bubbulle/CDR_ATOM_FACTORY_2019/Divers/Rapports/Base roulante CDR 2019.pdf

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

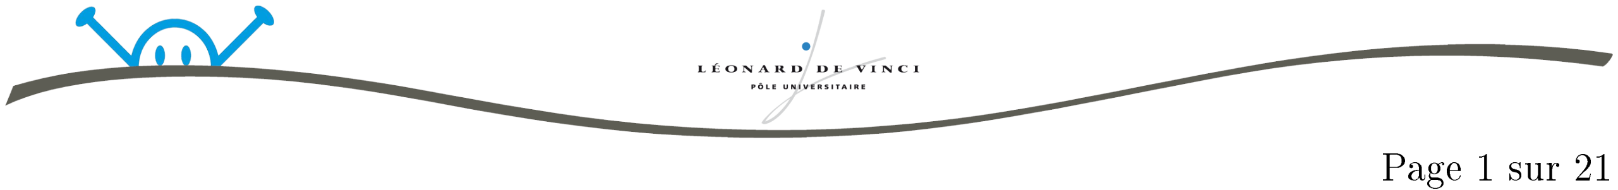
[picture p2: figure]

BASE ROULANTE CDR 2019

## Table des matières

1 | Dénir les moteurs | 4
2 | Conception de la base roulante en CAD | 7
3 | Fabrication de la base roulante | 10
4 | Système d'alimentation | 11
5 | Carte de contrôle des moteurs | 12
6 | Etude des codeurs incrémentaux | 13
7 | PID | 14
8 | ROS | 16
9 | Calcul de trajectoire simple à 2 points | 17
10 Système d'évitement | 18
11 Asservissement et vision par ordinateur | 19

Page 2 sur 21

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

## Dénir les moteurs

### Introduction

An de dénir les moteurs pour la CDR, il est important de justier nos choix par le calcul. En eet, il faut considérer la vitesse de déplacement du robot, le travail à eectuer et la puissance de chaque moteur.
Chaque mesure est prise de façon empirique, on veut juste avoir une approximation des résultats pour cibler nos recherches.
On suppose que la table sera toujours plan, ainsi le robot ne doit pas monter de pente. Dans le cas contraire, une nouvelle étude sera nécessaire.
Pour les calculs, on donne la longueur de la table 3m, le diamètre de la roue 50mm et le poids du robot 5kg.

### Dénir vitesse, puissance, et couple

Vitesse :
On souhaite parcourir la table en 5s : Vmax = D/t = 3m/5s = 0.6m.s⁻¹

Si les roues font 50mm de diamètre, leur périmètre est de :

Proue = π.d = π.0.05 = 0.15707m = 157.07mm

La vitesse de rotation à l'entrée des roues :

Nmax =

Vmax
Proue

.60 = 229, 20 tr.min⁻¹

ωmax =

2.π.N

60 | = 24, 00 | rad.s⁻¹

Page 4 sur 21

Travail des forces et énergie cinétique :

∆Ec =

XWFext | (1)

Ec = 1/2.m.V (t)

2
(2)

⇒ 1/2.m.(V (t)

2 − V (0)²
) = F.D où D est la distance parcouru par le robot

⇔ F = 1/2.m.V ²
max.

1
D
= 0.3N | (3)

Couple

C = F.d/2 = 0.3 ∗ 0.025 = 0.0075Nm = 7.5mNm | (4)

Puissance
P = F.Vmax = C.ωmax = 0, 18W | (5)

On remarque que le couple et la puissance sont calculés pour l'ensemble du robot et non pour chaque moteur.
On divise donc C et P par 2

Cmoteur = 3, 75 mNm

Pmoteur = 0.09 W

(6)

Accélération

On sait que :

m.a =

P
Fext

⇒ a =

F
m

=

0.3
5

= 0.06m.s⁻²
(7)

Page 5 sur 21

### Moteur Faulhäber

En cherchant dans le catalogue Faulhäber, on trouve :

DC-Micromotors Series 2642...CXR (https://www.faulhaber.com/en/products/series/2642cxr/) mettre datasheet dans dossier

Alimenté en Un = 12V , ce moteur tourne a une vitesse de N = 5800tr.min⁻¹ hors charge et un

couple max de Cmax = 25mNm.
En charge, on aura environ N = 5000tr.min⁻¹
et on remarque que le moteur, sans système d'engrenages, ne cédera pas face au couple nécessaire pour déplacer le robot.

Pour choisir le système d'engrenages, on calcul le rapport de réduction.

R =

Nmoteur.ηgearbox

Nmax

=

5000.0.83
230 = 18.04

D'après le catalogue, il existe :

Planetary Gearheads Series 26/1R (https://www.faulhaber.com/en/products/series/261r/)

mettre datasheet dans dossier

A cause d'un problème de dimension sur les poulies, on choisit le réducteur de rapport 14 :1. Ainsi, le rapport de réduction des poulies doit être de 1,86.

Page 6 sur 21

## Conception de la base roulante en CAD

### Introduction

Pour concevoir une base roulante stable, précise, et réutilisable, nous avons besoin que celle-ci soit facile à étudier, rapide à monter et surtout qu'elle réponde aux critères de précision. En eet, tout l'enjeu du robot est de pouvoir se déplacer avec le moins de contrainte possible. Les contraintes sont :

Entre-axe centré

Roue adhérente et bien xée

Pour des raisons de précision et tactique, des roues folles seront utilisées pour l'odométrie du robot. Ainsi, il y aura 2 types de roues, 2 roues large pour le mouvement et 2 roues folles pour les encodeurs. Toutes les roues ont le même diamètre pour éviter d'autres erreurs de calculs. Les roues folles sont placées le plus à l'extrémité pour augmenter la précision.

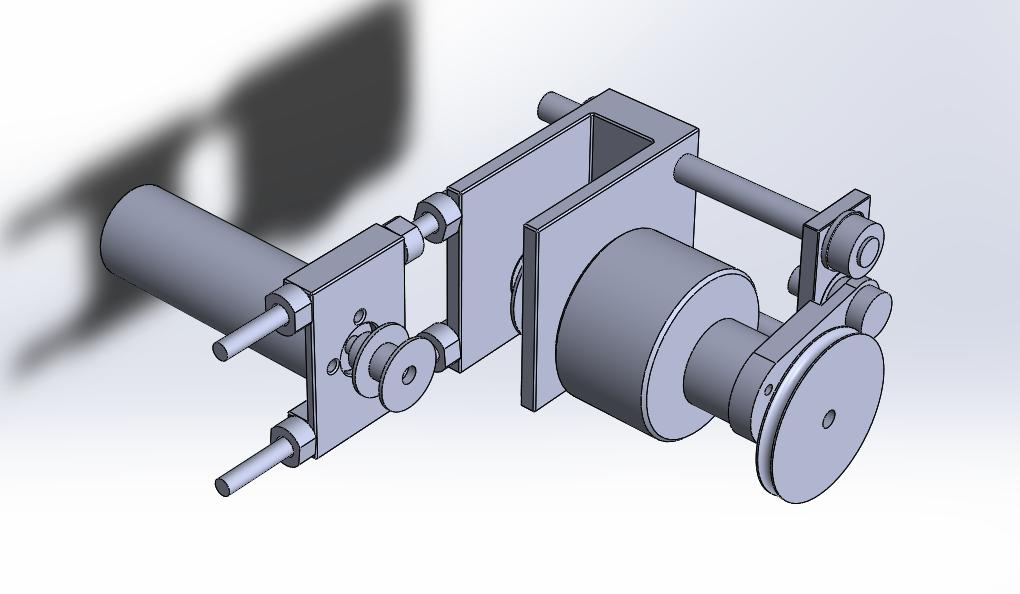
[picture p3: figure]

Page 7 sur 21

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

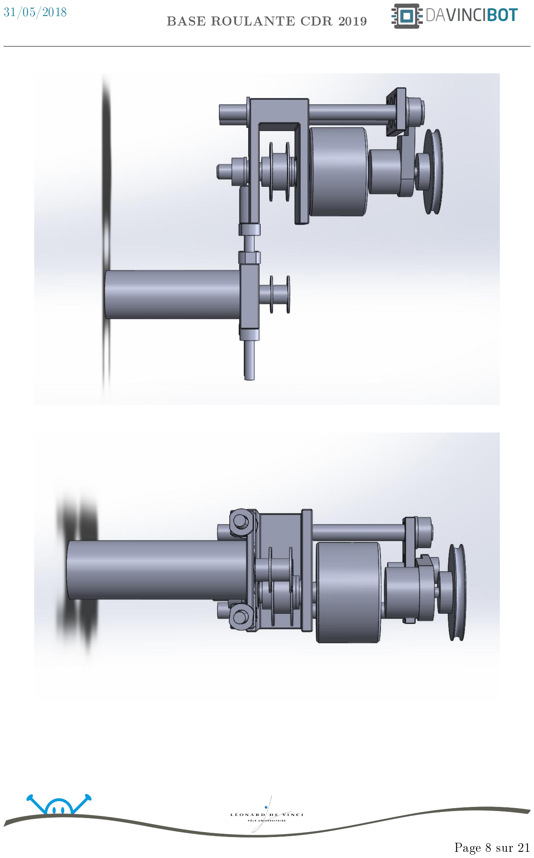
[picture p4: page 8]

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

## Etude des codeurs incrémentaux

Les codeurs incrémentaux sont utilisé pour mesurer les rotations eectuées. Très utilisés dans l'industrie, les codeurs nous servent pour l'odométrie du robot.

Il existe diérent type de codeurs, les magnétiques et les optiques. Chaque codeurs possède une résolution, celle-ci est mesurer en impulsions par tour.

Voici la réprésentation d'un disque pour les codeurs :

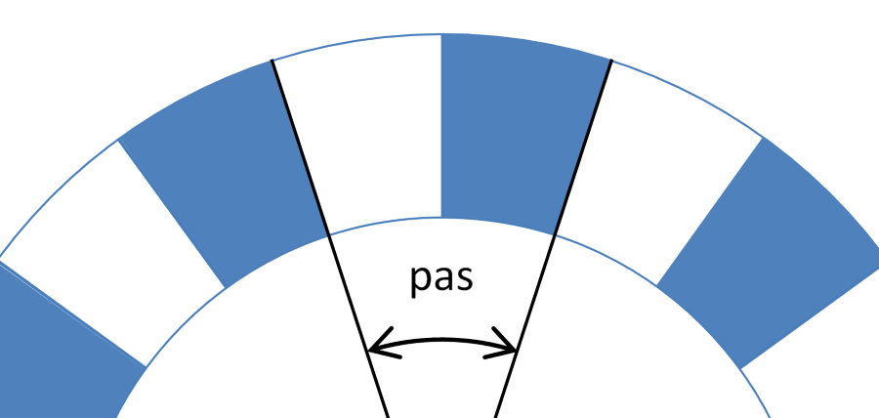
[picture p5: figure]

Le principe de fonctionnement est très bien expliqué sur ce site (http://arduino.blaisepascal.fr/index.php/2017/02/05/les-codeurs-incrementaux/)

Vous pourrez trouver les codes dans le chier "Codeurs incrémentaux". Les codes sont disponible en C pour arduino, C++ pour raspberry avec WiringPi, et enn en python pour raspberry avec RPi.GPIO

fait sur arduino, en cours sur rasp. sera nit pour vendredi 14

Page 13 sur 21

## PID

### Qu'est-ce que c'est ?

"Un correcteur est un algorithme de calcul qui délivre un signal de commande à partir de la diérence entre la consigne et la mesure."

Ce système est décomposé en 3 parties :

P (proportionnel)

PI (proportionnel et intégré)

PID (proportionnel, intégré, et dérivé)

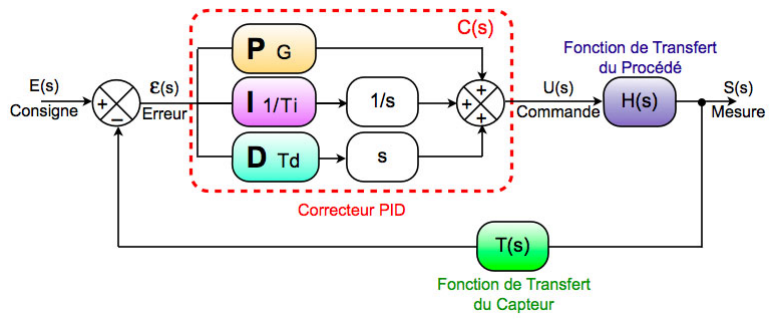
[picture p6: figure]

Pour avoir un régulateur précis, on utilise le correcteur PID. La correction résulte de la somme des trois P + I + D. On a la fonction de transfère, sous Laplace, suivante :

C(p) = G +

1
Ti

.p

+ Td.p | (8)

Page 14 sur 21

Le correcteur doit être bien dimensionné pour éviter les phénomènes d'oscillations et mi-nimiser le temps de réponse du système. On remarque ces deux phénomènes sur le graphique ci-dessous.

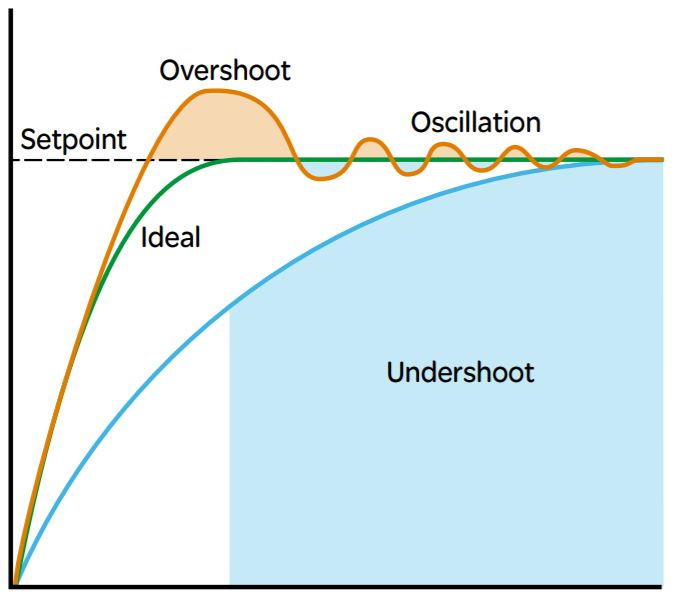
[picture p7: figure]

Les codes du PID en C++ et python ne sont pas disponible maintenant car ils n'ont pas été testés.

Page 15 sur 21

## ROS

Dans la partie ROS, nous allons implémenter des fonctionnalités plus poussée que celles de simples publisher et subscriber.
Il existe les services, et les actions. Les services sont utilisés comme un protocole dit : Request / Reply.

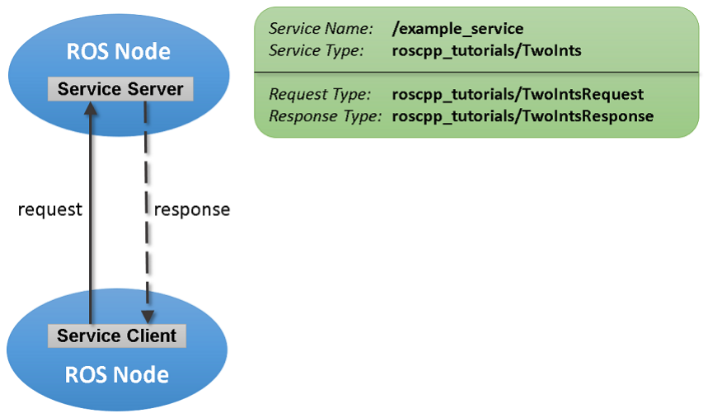
[picture p8: figure]

Les actions ont le même principe, seulement il existe plusieurs étapes intermédiaires entre la requête et la réponse. Voici le schéma d'organisation d'une action.

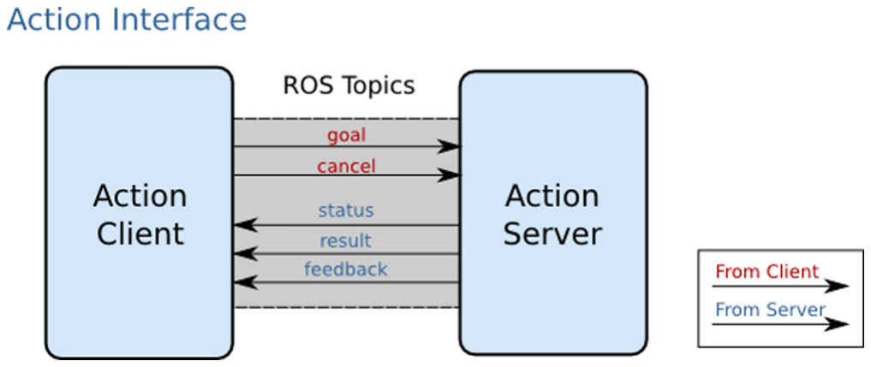
[picture p9: figure]

Pas de code utilisable

Page 16 sur 21

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
