bubbulle/CDR_ATOM_FACTORY_2019/CAO/Base Roulante/SW_BR_3.0/IMP_ECRAN/cote_3.0.png

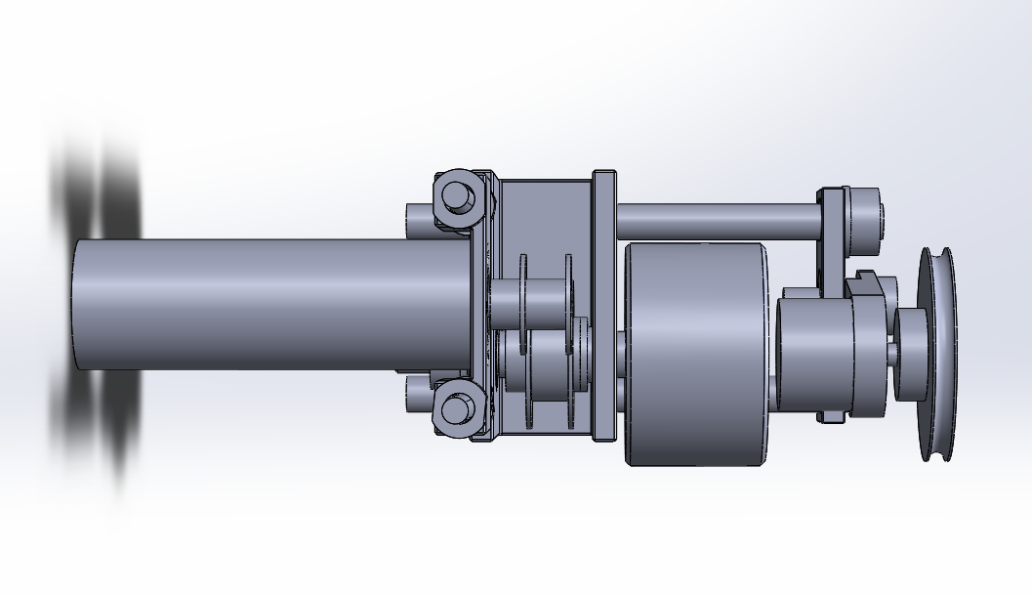
CAO/Base Roulante/SW_BR_3.0/IMP_ECRAN/cote_3.0.png
