bubbulle/CDR_ATOM_FACTORY_2019/CAO/Base Roulante/SW_BR_1.0/Assemblage1.SLDASM

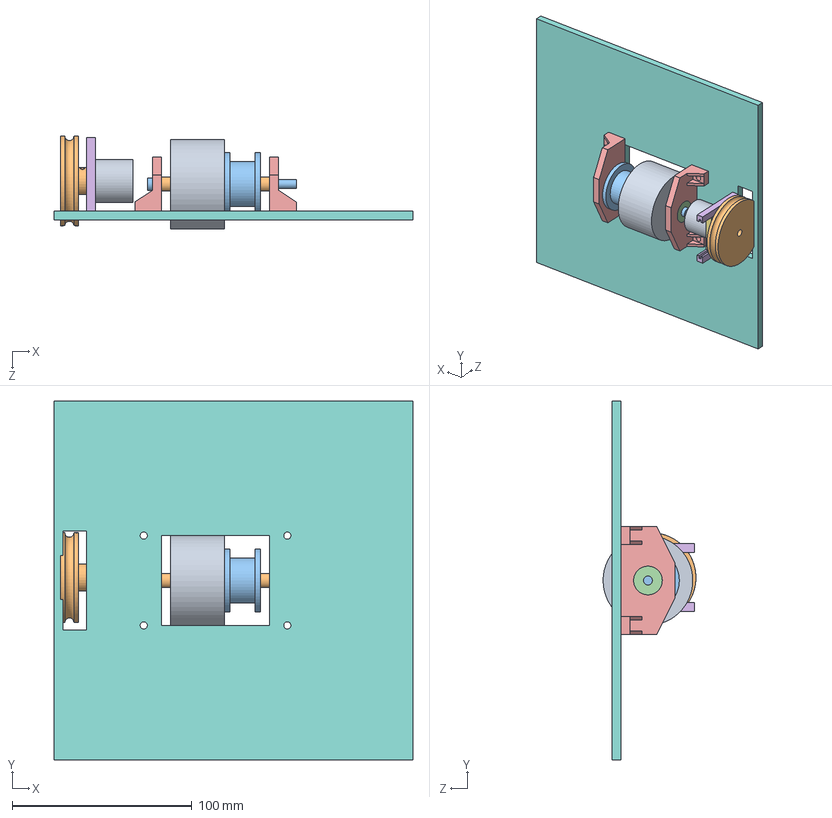
[picture p12: CAD file, 2018-09-26]
CAO/Base Roulante/SW_BR_1.0/Assemblage1.SLDASM
200.0 x 200.0 x 51.7 mm
roues
cale moteur x 2
poulie
roulement 5x16 x 2
support roues vé x 2
support du support encodeur
support encodeur
base
encodeur
rouefolle
axe roues
goupille
