bubbulle/CDR_ATOM_FACTORY_2019/CAO/Base Roulante/SW_BR_2.0/Assemblage1.SLDASM

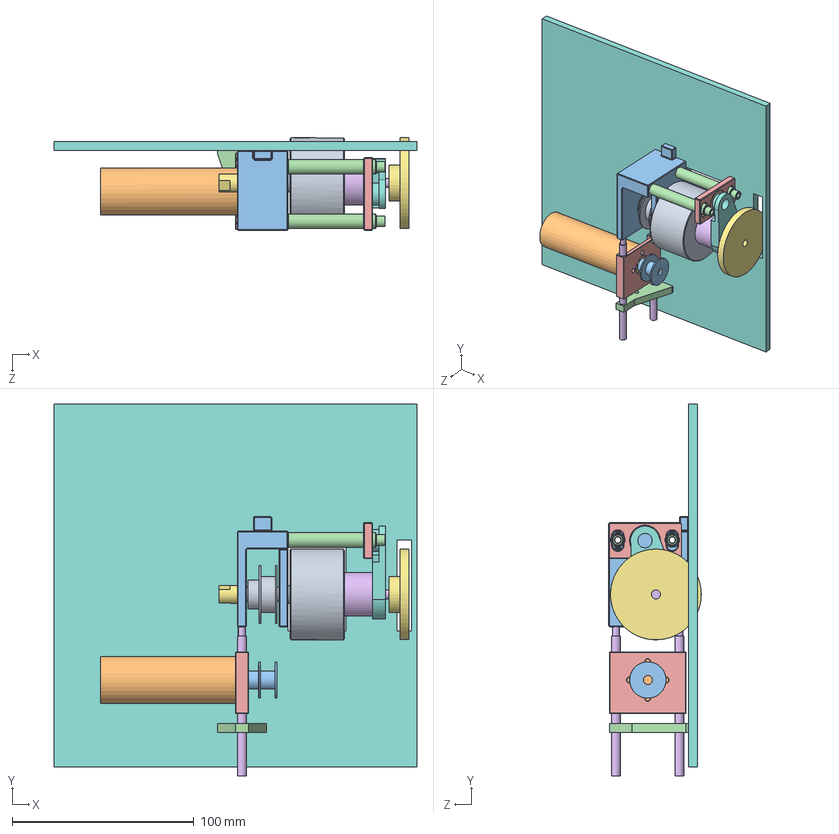
[picture p13: CAD file, 2018-09-26]
CAO/Base Roulante/SW_BR_2.0/Assemblage1.SLDASM
200.0 x 204.9 x 51.0 mm
roues
roulement 8int 16ext x 3
support roues
tige support encodeur x 2
support encodeurs
codeurs
roue folle
base
poulie
moteur faulhaber
poulie 20 dents
fixation tige support moteur
Pièce1
tige x 2
fixation encodeur V3
