bubbulle/CDR_ATOM_FACTORY_2019/CAO/Base Roulante/SW_BR_3.0/3.0/Base V3.SLDASM

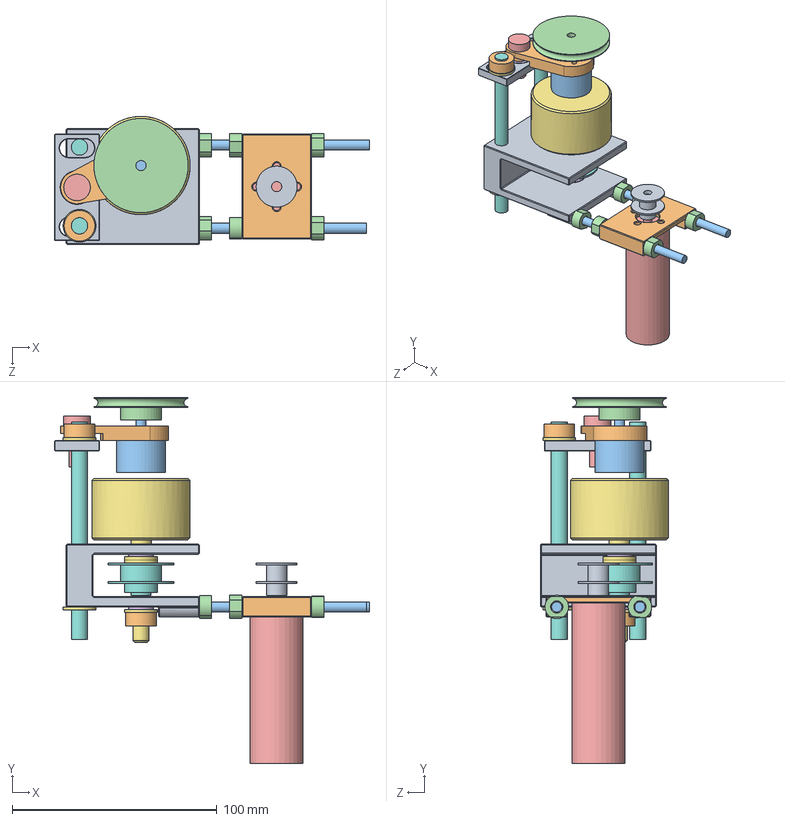
[picture p14: CAD file, 2018-09-26]
CAO/Base Roulante/SW_BR_3.0/3.0/Base V3.SLDASM
153.7 x 178.6 x 62.6 mm
Support fixe V3
support moteur V3
tige filetée M6 x 2
ecrou M6 x 6
moteur faulhaber
roulement 8int 16ext x 3
roues
tige filté M7 x 2
support encodeurs
fixation encodeur V3
codeurs
roue folle
vis M8 20L
rondelle M6 percée en M8 x 2
rondelle M8 x 5
poulie
poulie 20 dents
ecrou M8 x 2
