bubbulle/CDR_ATOM_FACTORY_2019/CAO/Base Roulante/SW_BR_1.0/support du support encodeur.SLDPRT

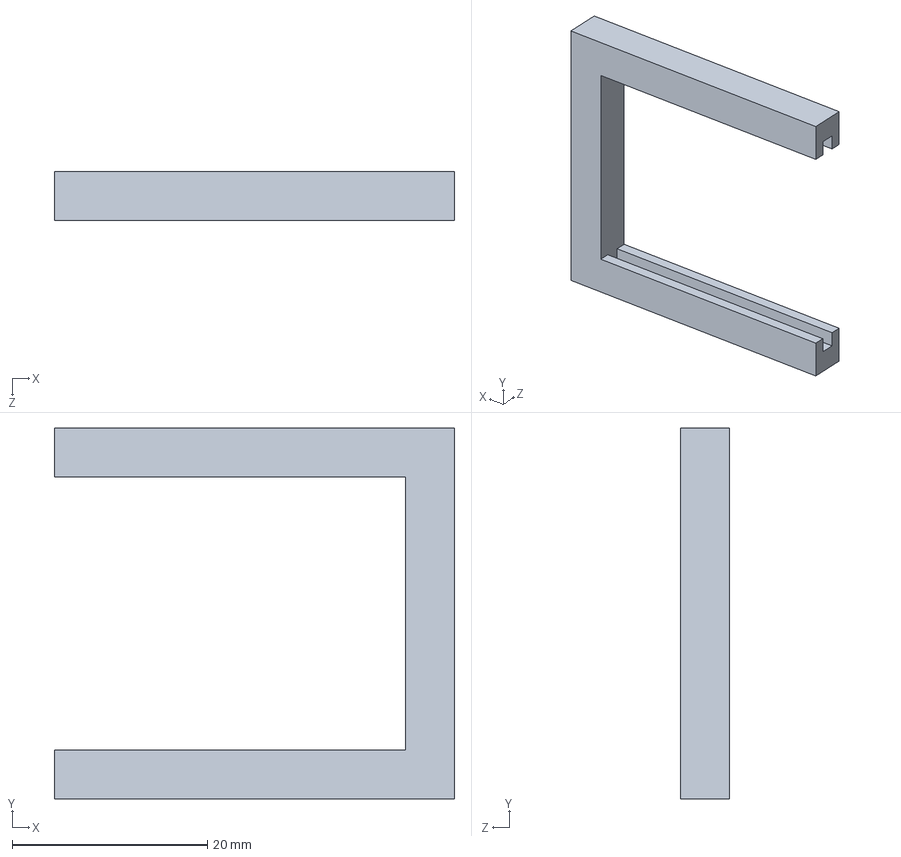
[picture p15: CAD file, 2018-09-26]
CAO/Base Roulante/SW_BR_1.0/support du support encodeur.SLDPRT
41.0 x 38.0 x 5.00 mm
