bubbulle/CDR_ATOM_FACTORY_2019/CAO/Base Roulante/SW_BR_3.0/3.0/roulement 8int 16ext.SLDPRT

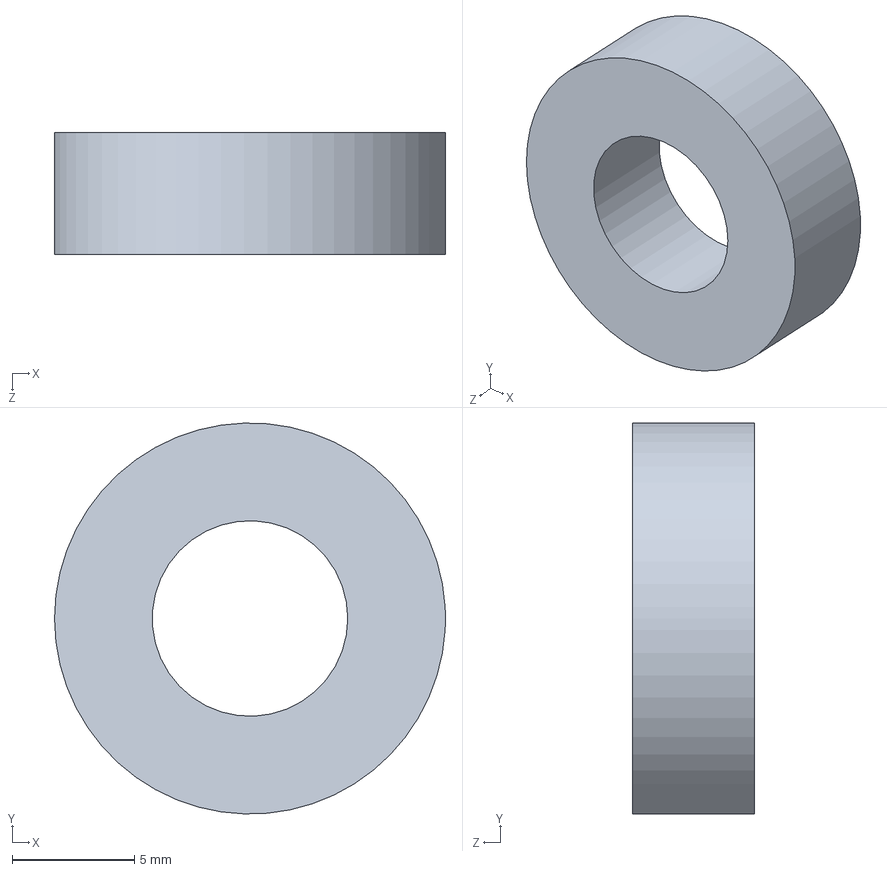
[picture p17: CAD file, 2018-09-26]
CAO/Base Roulante/SW_BR_3.0/3.0/roulement 8int 16ext.SLDPRT
16.0 x 16.0 x 5.00 mm
