bubbulle/CDR_ATOM_FACTORY_2019/CAO/Base Roulante/SW_BR_1.0/vis pour poulie.SLDPRT

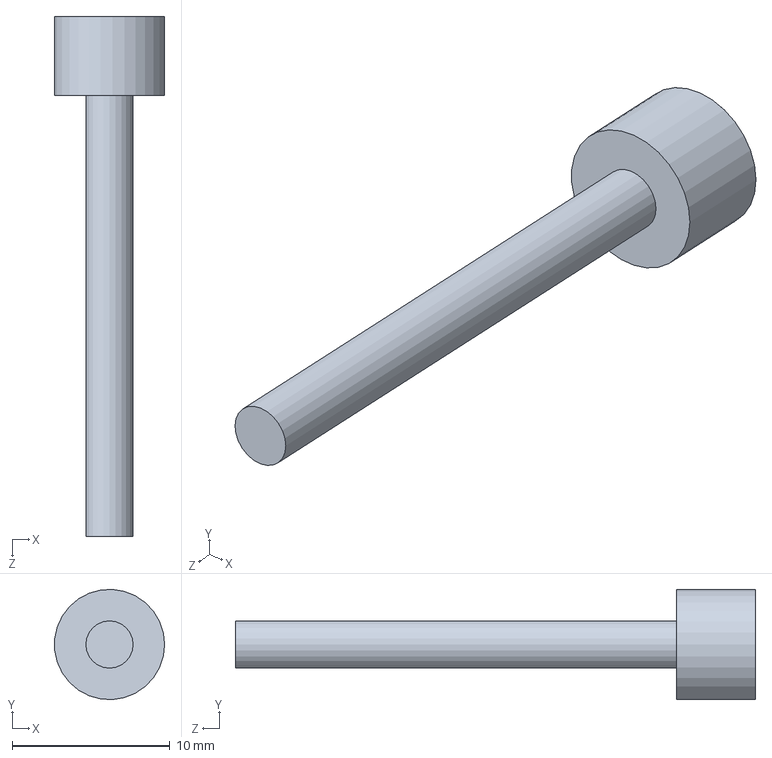
[picture p18: CAD file, 2018-09-26]
CAO/Base Roulante/SW_BR_1.0/vis pour poulie.SLDPRT
7.00 x 6.99 x 33.0 mm
