bubbulle/CDR_ATOM_FACTORY_2019/CAO/Base Roulante/SW_BR_2.0/base.SLDPRT

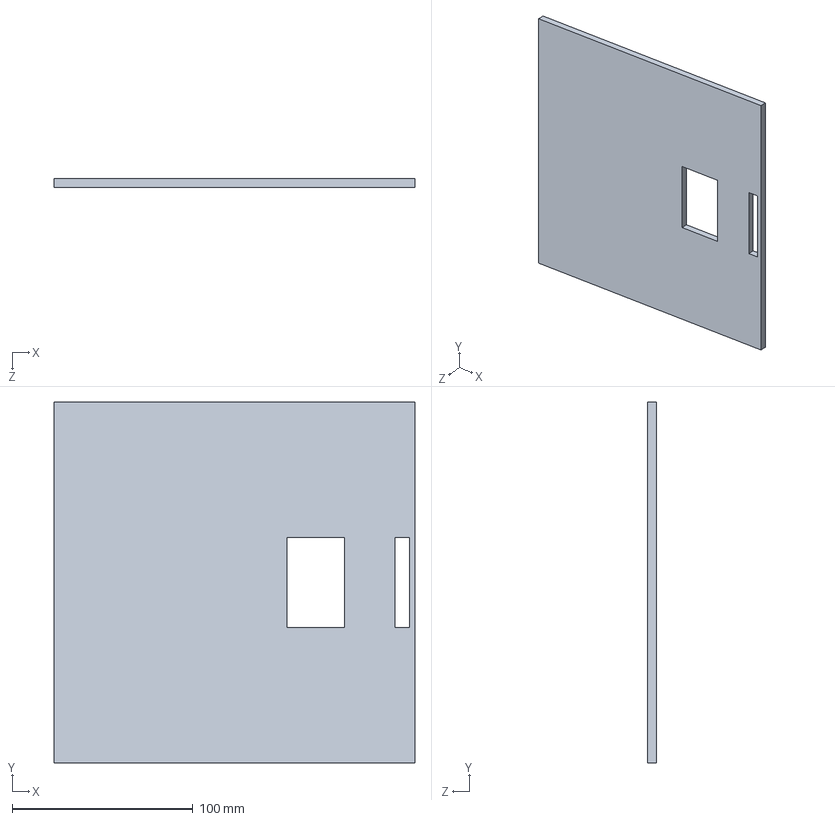
[picture p19: CAD file, 2018-09-26]
CAO/Base Roulante/SW_BR_2.0/base.SLDPRT
200.0 x 200.0 x 5.00 mm
