bubbulle/CDR_ATOM_FACTORY_2019/CAO/Base Roulante/SW_BR_3.0/3.0/rondelle M8.SLDPRT

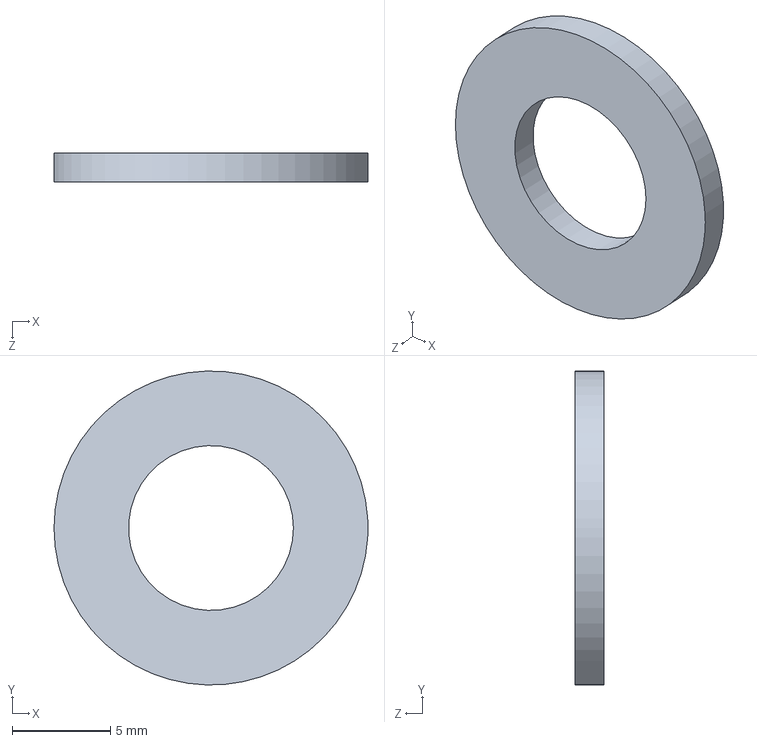
[picture p20: CAD file, 2018-09-26]
CAO/Base Roulante/SW_BR_3.0/3.0/rondelle M8.SLDPRT
16.0 x 16.0 x 1.50 mm
