bubbulle/CDR_ATOM_FACTORY_2019/CAO/Base Roulante/SW_BR_1.0/support roues.SLDPRT

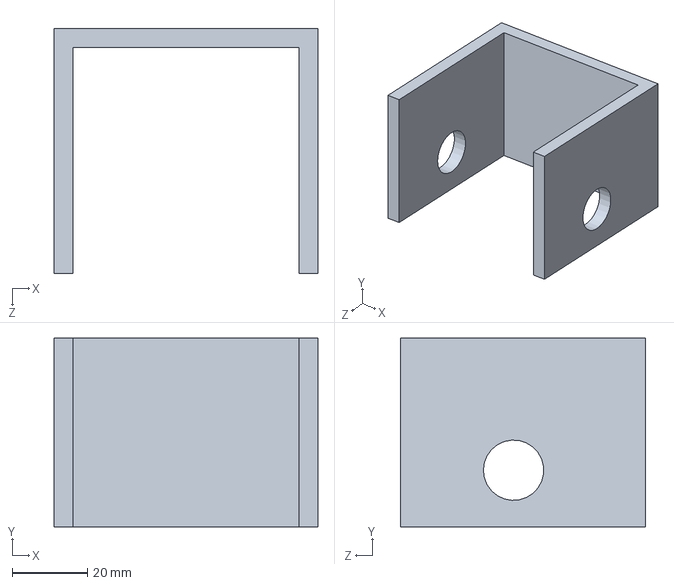
[picture p21: CAD file, 2018-09-26]
CAO/Base Roulante/SW_BR_1.0/support roues.SLDPRT
70.0 x 50.0 x 65.0 mm
