bubbulle/CDR_ATOM_FACTORY_2019/CAO/Base Roulante/SW_BR_2.0/ecrou axe central.SLDPRT

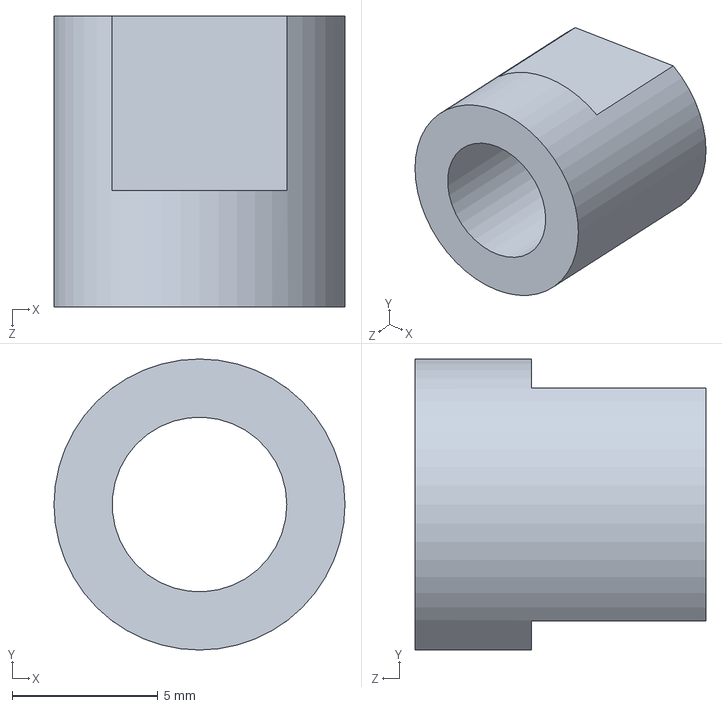
[picture p22: CAD file, 2018-09-26]
CAO/Base Roulante/SW_BR_2.0/ecrou axe central.SLDPRT
10.0 x 10.0 x 10.0 mm
