bubbulle/CDR_ATOM_FACTORY_2019/CAO/Base Roulante/SW_BR_3.0/3.0/tige filetée M6.SLDPRT

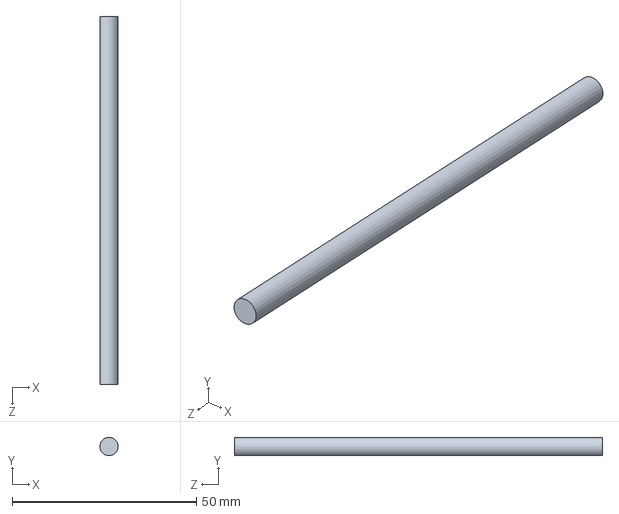
[picture p23: CAD file, 2018-09-26]
CAO/Base Roulante/SW_BR_3.0/3.0/tige filetée M6.SLDPRT
5.00 x 5.00 x 100.0 mm
