bubbulle/CDR_ATOM_FACTORY_2019/CAO/Base Roulante/SW_BR_1.0/support encodeur.SLDPRT

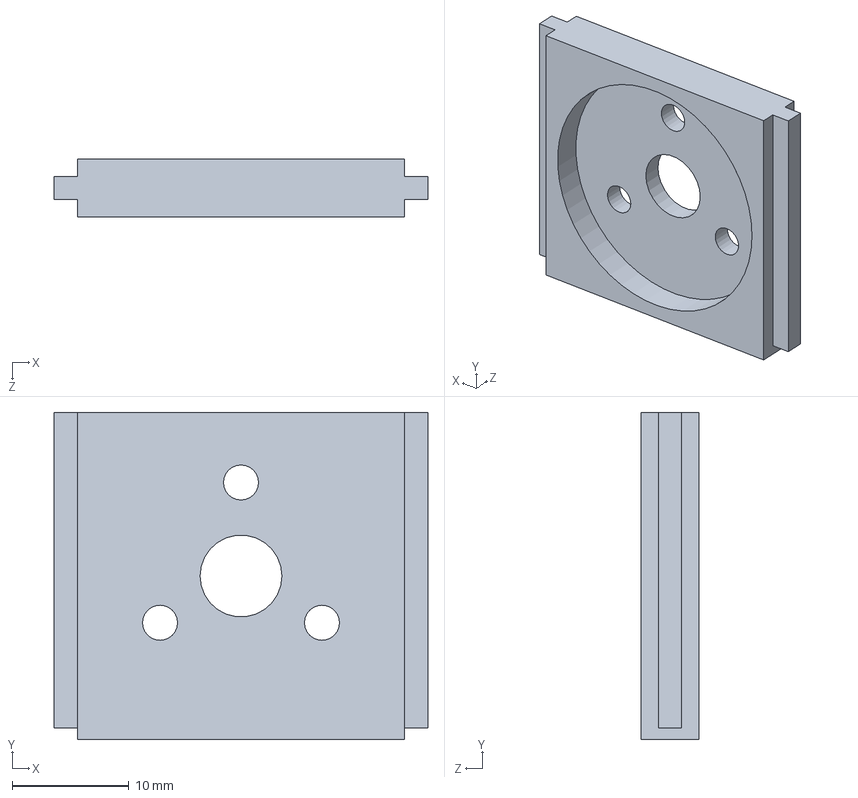
[picture p24: CAD file, 2018-09-26]
CAO/Base Roulante/SW_BR_1.0/support encodeur.SLDPRT
32.0 x 28.0 x 5.00 mm
