bubbulle/CDR_ATOM_FACTORY_2019/CAO/Base Roulante/SW_BR_2.0/poulie.SLDPRT

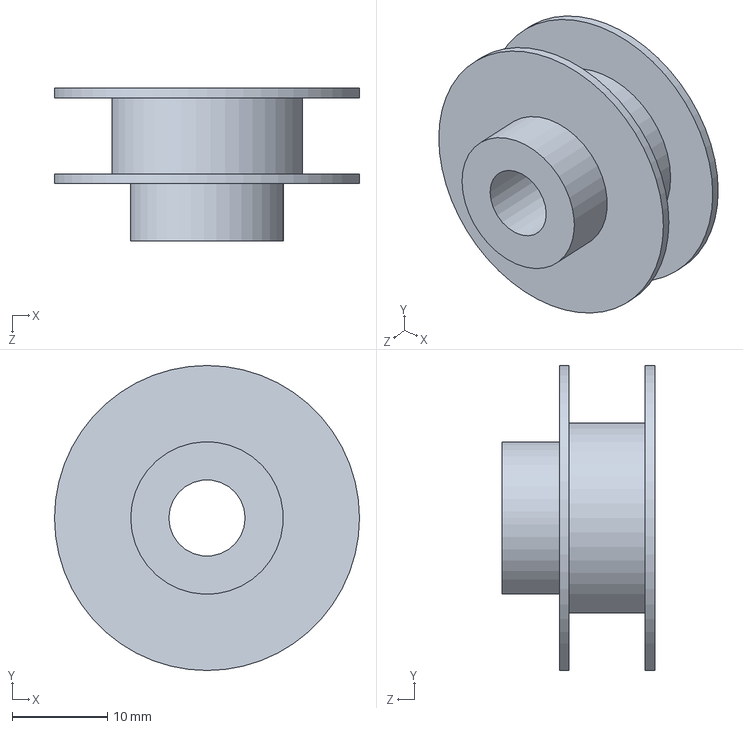
[picture p25: CAD file, 2018-09-26]
CAO/Base Roulante/SW_BR_2.0/poulie.SLDPRT
32.0 x 32.0 x 16.0 mm
