bubbulle/CDR_ATOM_FACTORY_2019/CAO/Base Roulante/SW_BR_3.0/3.0/rondelle M6 percée en M8.SLDPRT

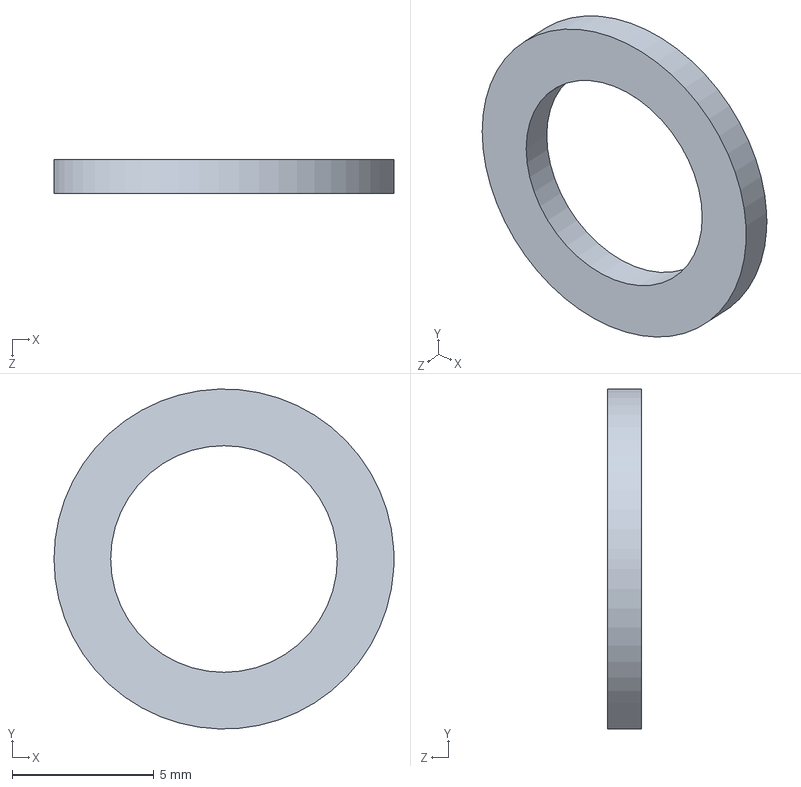
[picture p26: CAD file, 2018-09-26]
CAO/Base Roulante/SW_BR_3.0/3.0/rondelle M6 percée en M8.SLDPRT
12.0 x 12.0 x 1.20 mm
