bubbulle/CDR_ATOM_FACTORY_2019/CAO/Base Roulante/SW_BR_1.0/suppor encodeur.SLDPRT

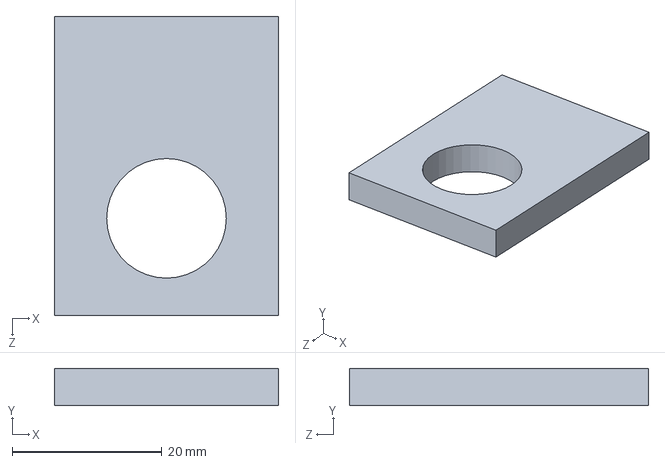
[picture p27: CAD file, 2018-09-26]
CAO/Base Roulante/SW_BR_1.0/suppor encodeur.SLDPRT
30.0 x 5.00 x 40.0 mm
