bubbulle/CDR_ATOM_FACTORY_2019/CAO/Base Roulante/SW_BR_2.0/fixation tige support moteur.SLDPRT

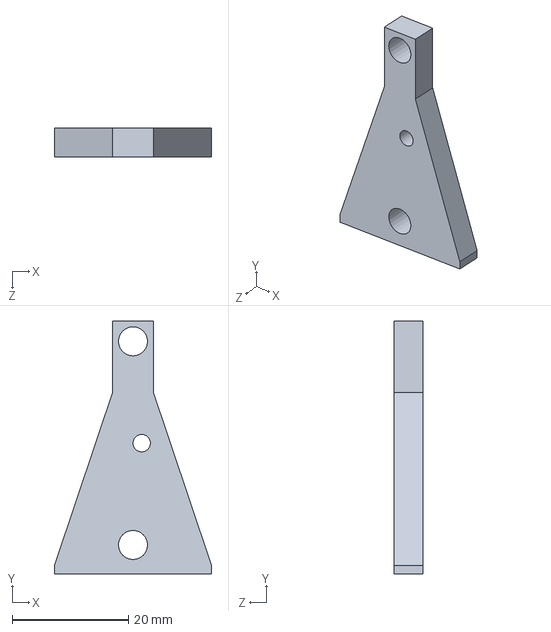
[picture p28: CAD file, 2018-09-26]
CAO/Base Roulante/SW_BR_2.0/fixation tige support moteur.SLDPRT
27.0 x 43.5 x 5.00 mm
