bubbulle/CDR_ATOM_FACTORY_2019/CAO/Base Roulante/SW_BR_3.0/3.0/roue folle.SLDPRT

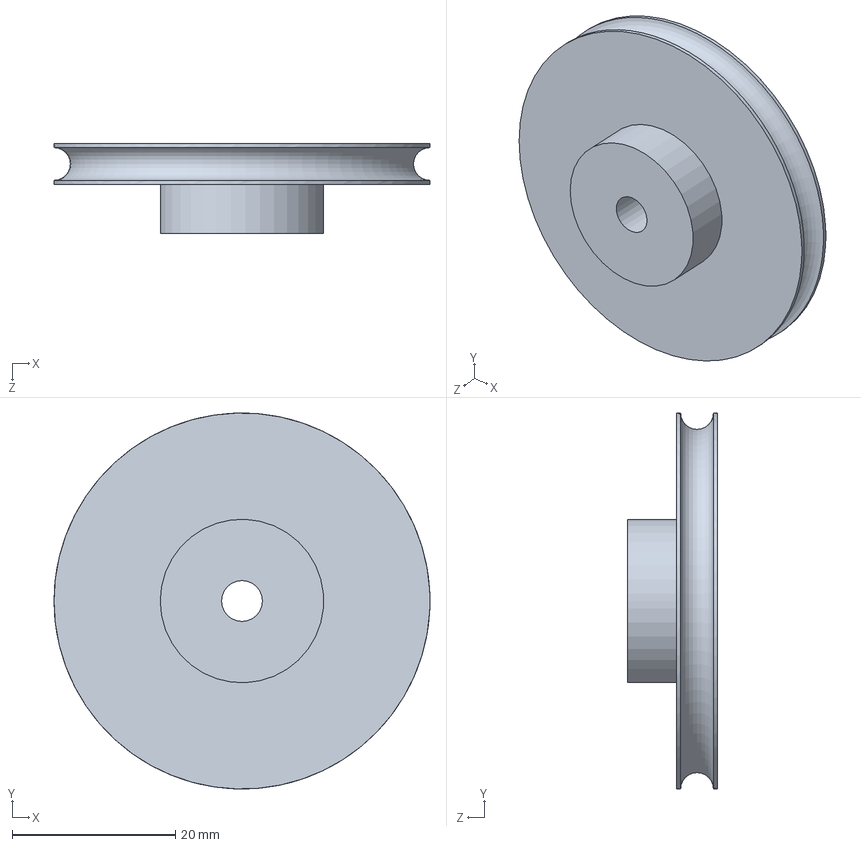
[picture p29: CAD file, 2018-09-26]
CAO/Base Roulante/SW_BR_3.0/3.0/roue folle.SLDPRT
46.0 x 46.0 x 11.0 mm
