bubbulle/CDR_ATOM_FACTORY_2019/CAO/Base Roulante/SW_BR_2.0/fixation encodeur.SLDPRT

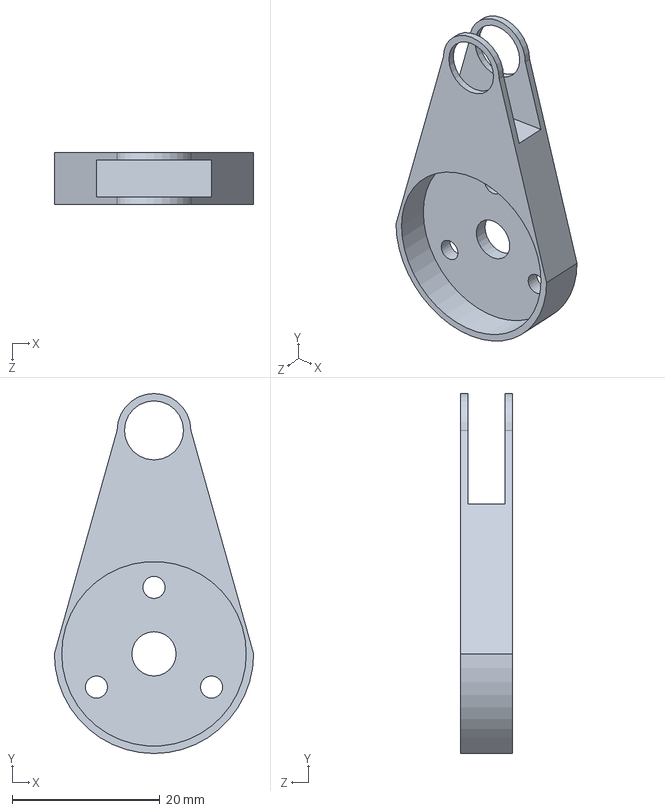
[picture p30: CAD file, 2018-09-26]
CAO/Base Roulante/SW_BR_2.0/fixation encodeur.SLDPRT
27.0 x 48.8 x 7.00 mm
