bubbulle/CDR_ATOM_FACTORY_2019/CAO/Base Roulante/SW_BR_3.0/3.0/cale ecrou M8.SLDPRT

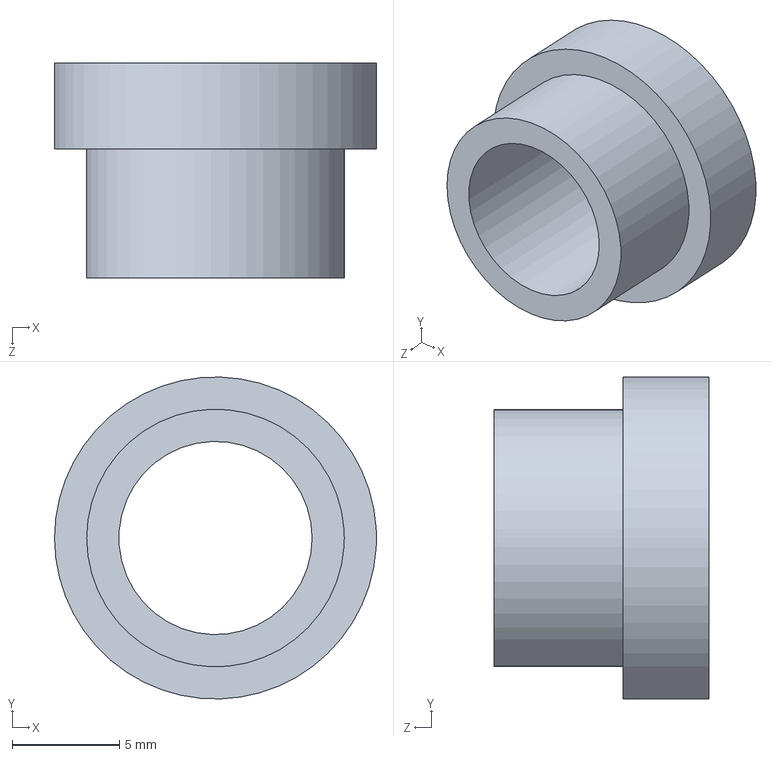
[picture p31: CAD file, 2018-09-26]
CAO/Base Roulante/SW_BR_3.0/3.0/cale ecrou M8.SLDPRT
15.0 x 15.0 x 10.0 mm
