bubbulle/CDR_ATOM_FACTORY_2019/CAO/Base Roulante/SW_BR_1.0/roulement 5x16.SLDPRT

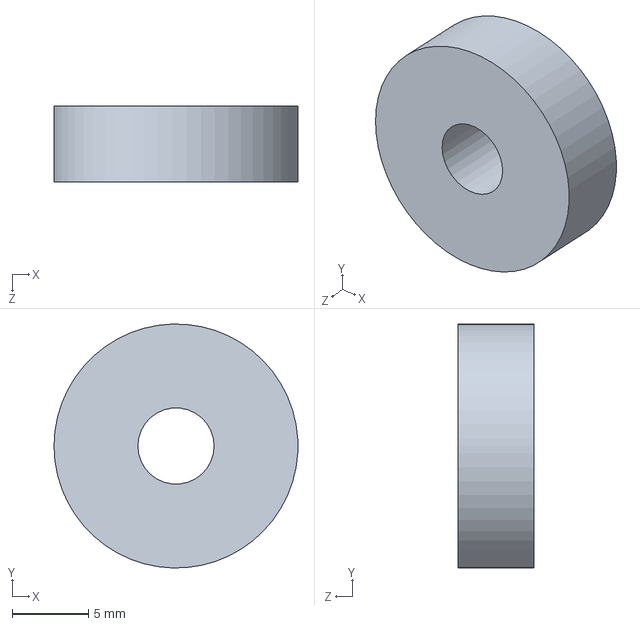
[picture p32: CAD file, 2018-09-26]
CAO/Base Roulante/SW_BR_1.0/roulement 5x16.SLDPRT
16.0 x 16.0 x 5.00 mm
