bubbulle/CDR_ATOM_FACTORY_2019/CAO/Base Roulante/SW_BR_2.0/fixation moteur.SLDPRT

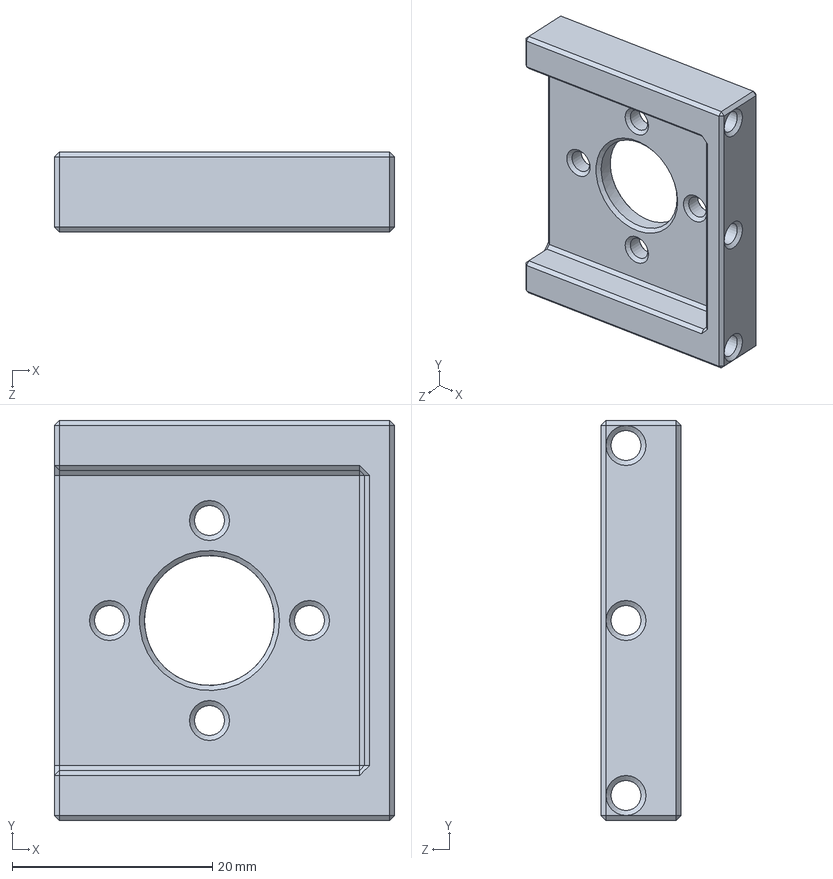
[picture p33: CAD file, 2018-09-26]
CAO/Base Roulante/SW_BR_2.0/fixation moteur.SLDPRT
34.0 x 40.0 x 8.00 mm
