bubbulle/CDR_ATOM_FACTORY_2019/CAO/Base Roulante/SW_BR_3.0/3.0/support encodeurs.SLDPRT

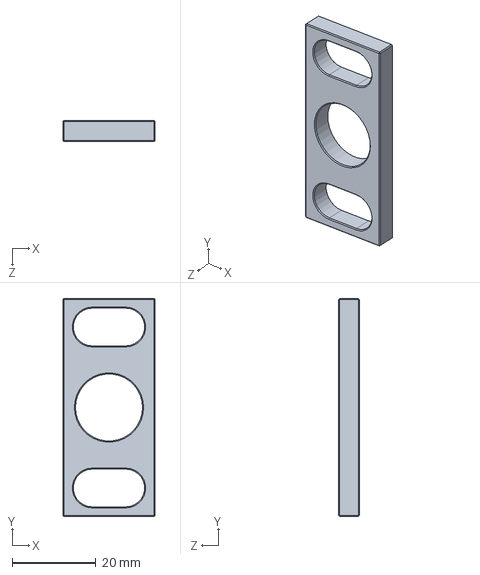
[picture p34: CAD file, 2018-09-26]
CAO/Base Roulante/SW_BR_3.0/3.0/support encodeurs.SLDPRT
22.0 x 52.0 x 5.00 mm
