bubbulle/CDR_ATOM_FACTORY_2019/CAO/Base Roulante/SW_BR_1.0/roues.SLDPRT

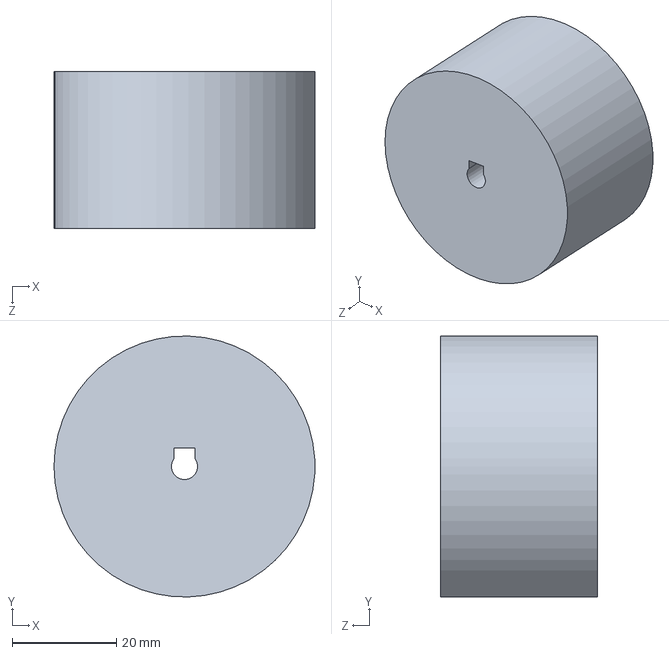
[picture p35: CAD file, 2018-09-26]
CAO/Base Roulante/SW_BR_1.0/roues.SLDPRT
50.0 x 50.0 x 30.0 mm
