bubbulle/CDR_ATOM_FACTORY_2019/CAO/Base Roulante/SW_BR_2.0/roue folle.SLDPRT

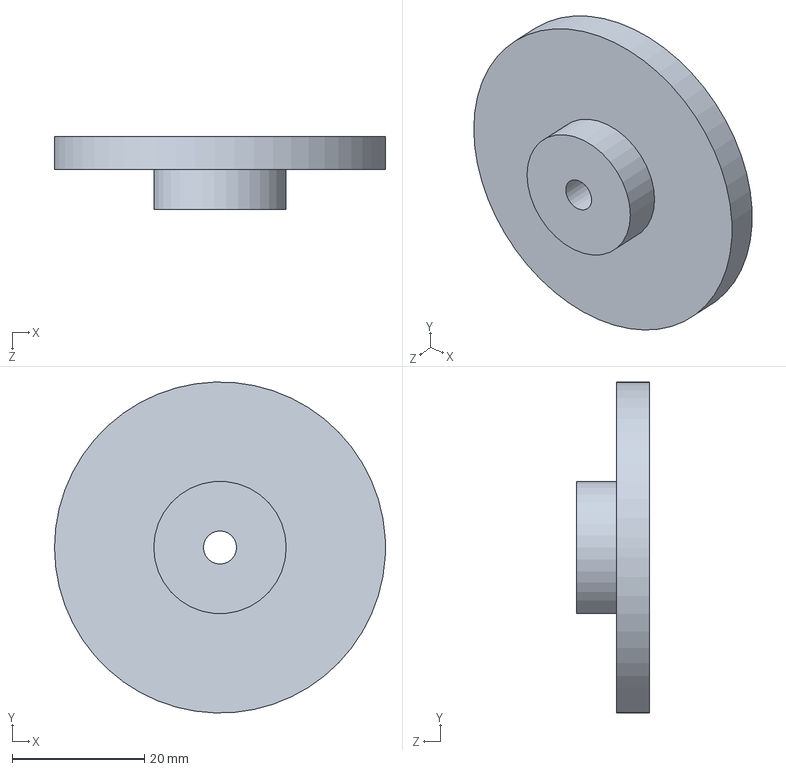
[picture p36: CAD file, 2018-09-26]
CAO/Base Roulante/SW_BR_2.0/roue folle.SLDPRT
50.0 x 50.0 x 11.0 mm
