bubbulle/CDR_ATOM_FACTORY_2019/CAO/Base Roulante/SW_BR_3.0/3.0/vis M8 20L.SLDPRT

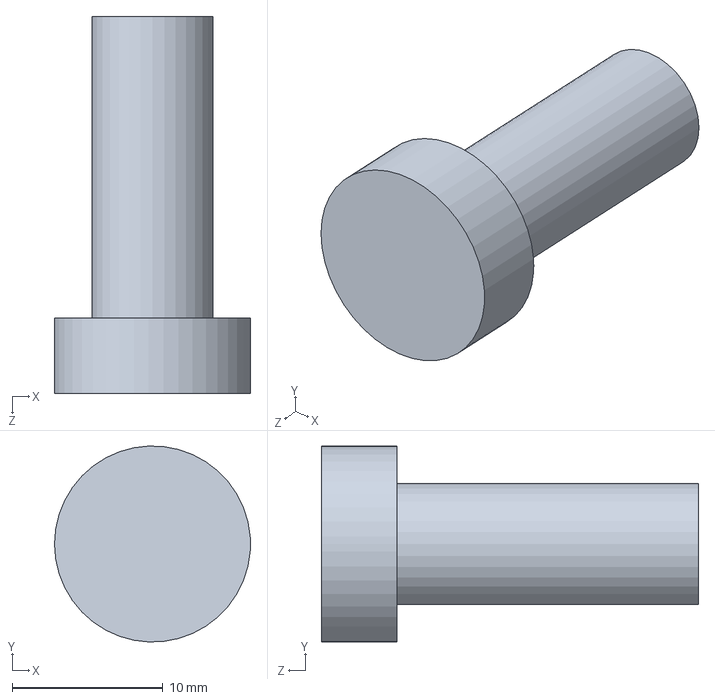
[picture p37: CAD file, 2018-09-26]
CAO/Base Roulante/SW_BR_3.0/3.0/vis M8 20L.SLDPRT
13.0 x 13.0 x 25.0 mm
