bubbulle/CDR_ATOM_FACTORY_2019/CAO/Base Roulante/SW_BR_1.0/axe roues.SLDPRT

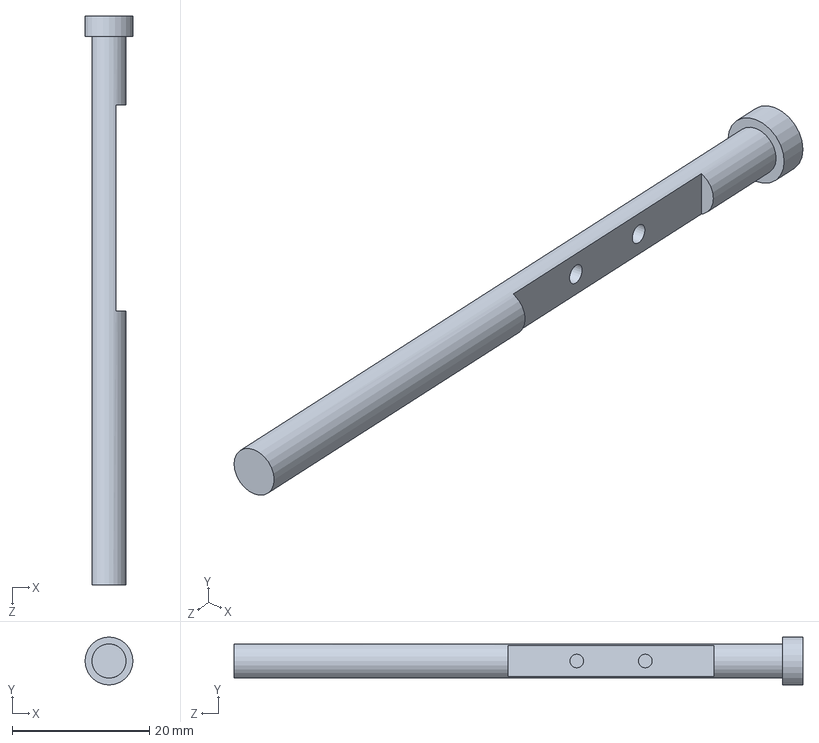
[picture p38: CAD file, 2018-09-26]
CAO/Base Roulante/SW_BR_1.0/axe roues.SLDPRT
7.00 x 7.00 x 83.0 mm
