bubbulle/CDR_ATOM_FACTORY_2019/CAO/Base Roulante/SW_BR_3.0/3.0/support moteur V3.SLDPRT

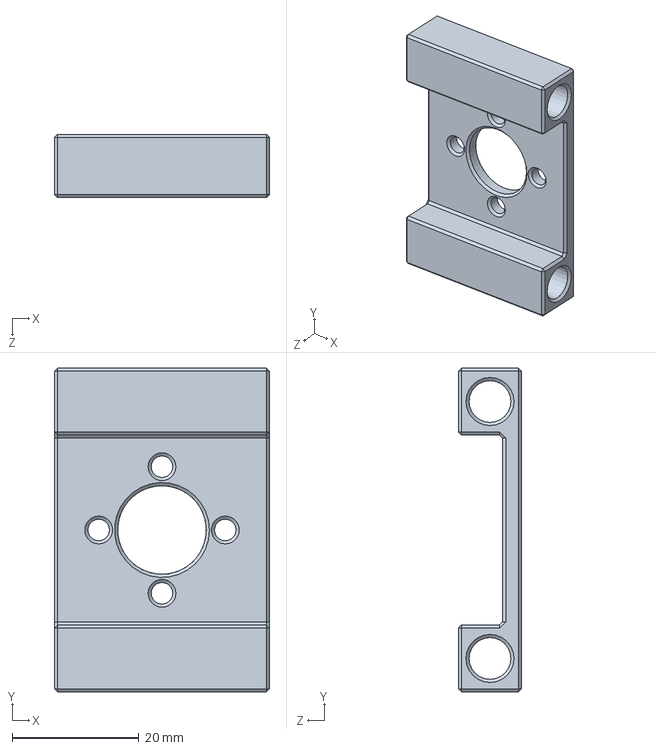
[picture p39: CAD file, 2018-09-26]
CAO/Base Roulante/SW_BR_3.0/3.0/support moteur V3.SLDPRT
34.0 x 51.2 x 10.0 mm
