bubbulle/CDR_ATOM_FACTORY_2019/CAO/Base Roulante/SW_BR_1.0/rouefolle.SLDPRT

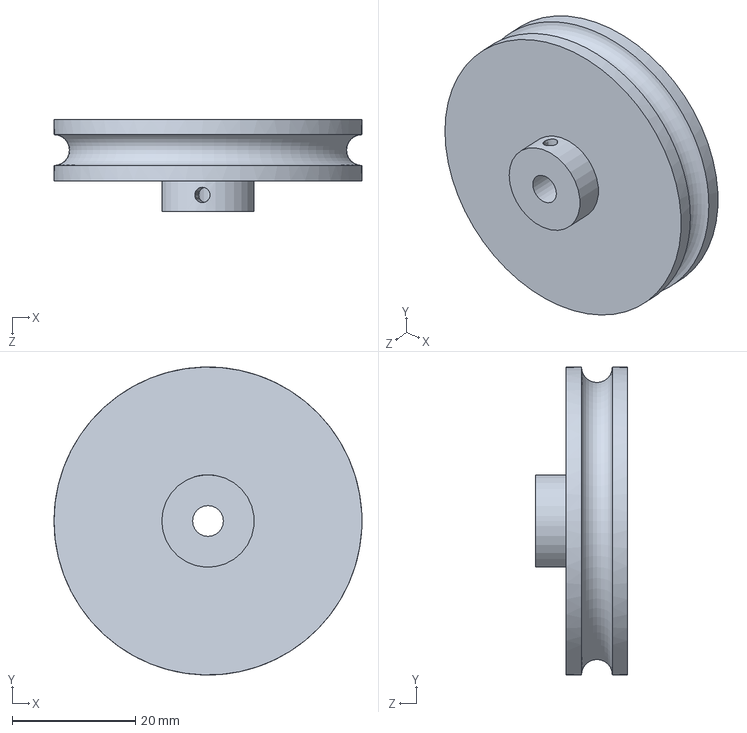
[picture p40: CAD file, 2018-09-26]
CAO/Base Roulante/SW_BR_1.0/rouefolle.SLDPRT
50.0 x 50.0 x 15.0 mm
