bubbulle/CDR_ATOM_FACTORY_2019/CAO/Base Roulante/SW_BR_2.0/moteur faulhaber.SLDPRT

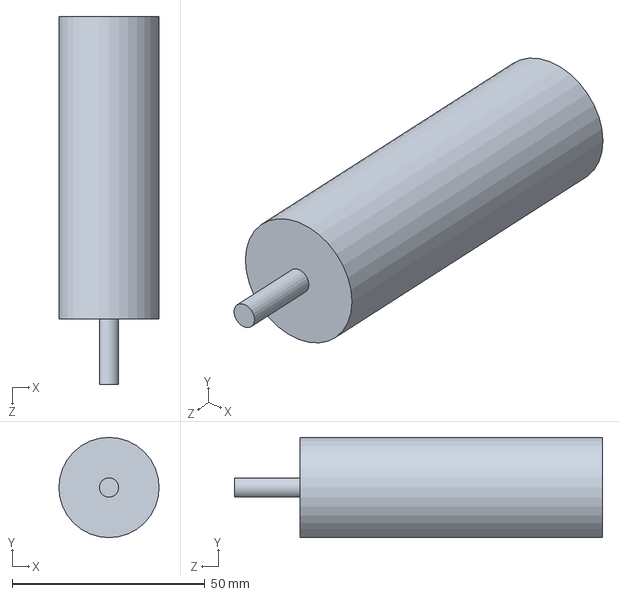
[picture p41: CAD file, 2018-09-26]
CAO/Base Roulante/SW_BR_2.0/moteur faulhaber.SLDPRT
26.0 x 26.0 x 95.4 mm
