bubbulle/CDR_ATOM_FACTORY_2019/CAO/Base Roulante/SW_BR_3.0/3.0/cale 8 int.SLDPRT

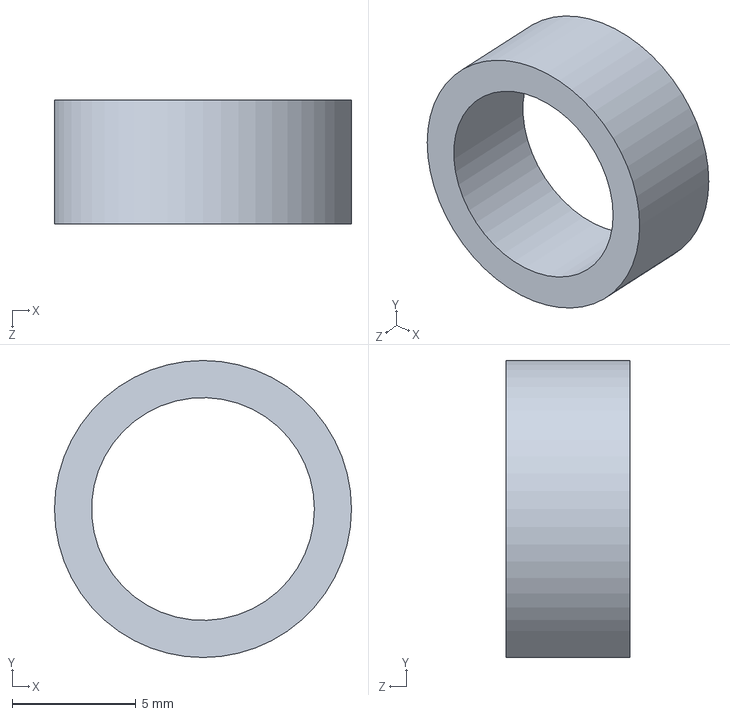
[picture p42: CAD file, 2018-09-26]
CAO/Base Roulante/SW_BR_3.0/3.0/cale 8 int.SLDPRT
12.0 x 12.0 x 5.00 mm
