bubbulle/CDR_ATOM_FACTORY_2019/CAO/Base Roulante/SW_BR_2.0/tige support encodeur.SLDPRT

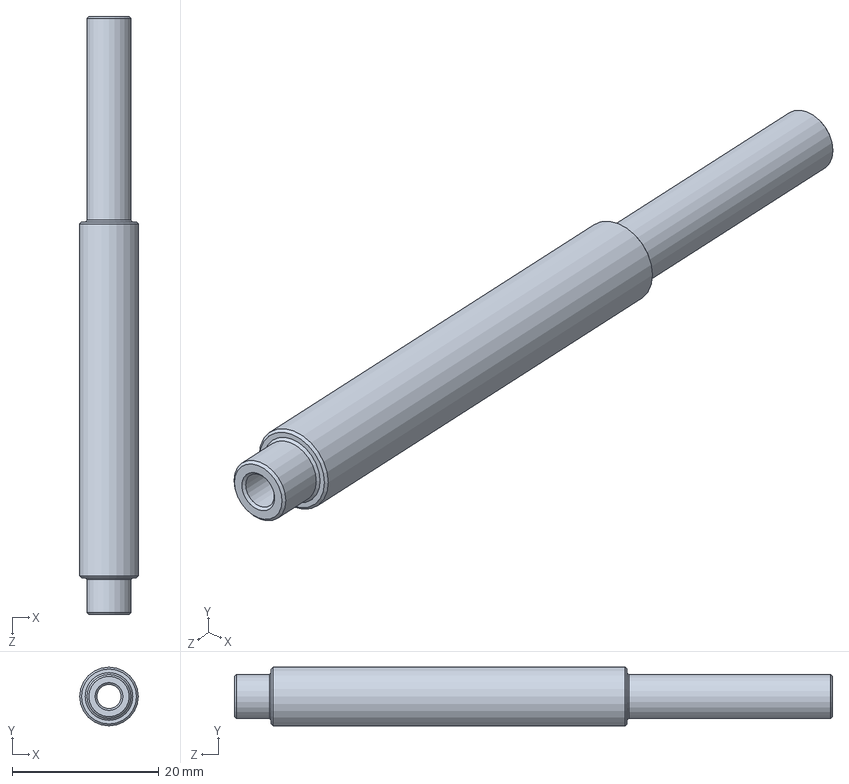
[picture p44: CAD file, 2018-09-26]
CAO/Base Roulante/SW_BR_2.0/tige support encodeur.SLDPRT
8.00 x 8.00 x 81.5 mm
