bubbulle/CDR_ATOM_FACTORY_2019/CAO/Base Roulante/SW_BR_1.0/cale moteur.SLDPRT

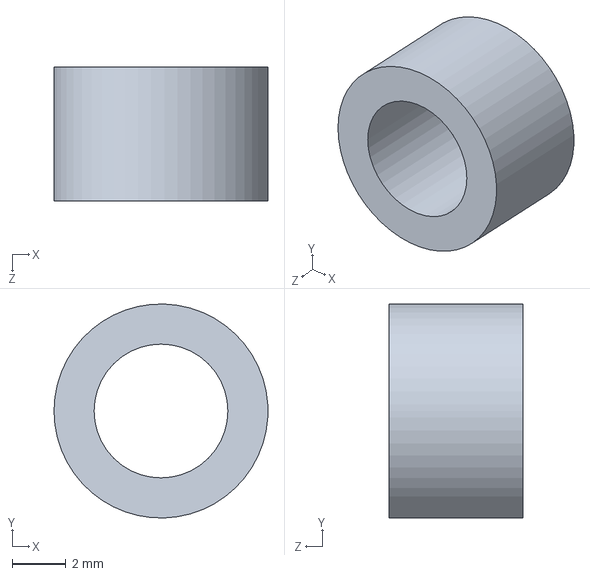
[picture p45: CAD file, 2018-09-26]
CAO/Base Roulante/SW_BR_1.0/cale moteur.SLDPRT
8.00 x 8.00 x 5.00 mm
