bubbulle/CDR_ATOM_FACTORY_2019/CAO/Base Roulante/SW_BR_3.0/3.0/poulie 20 dents.SLDPRT

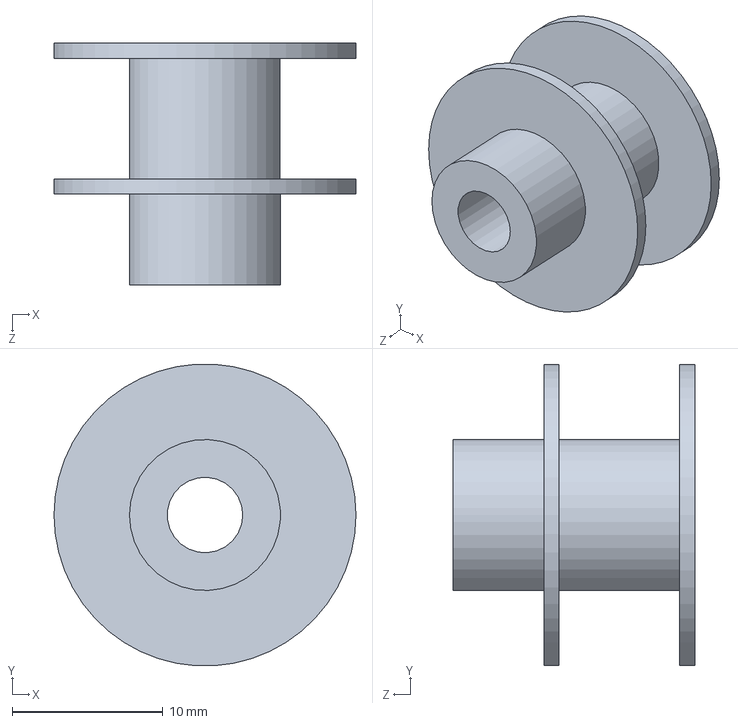
[picture p47: CAD file, 2018-09-26]
CAO/Base Roulante/SW_BR_3.0/3.0/poulie 20 dents.SLDPRT
20.0 x 20.0 x 16.0 mm
