bubbulle/CDR_ATOM_FACTORY_2019/CAO/Base Roulante/SW_BR_1.0/support roues vé.SLDPRT

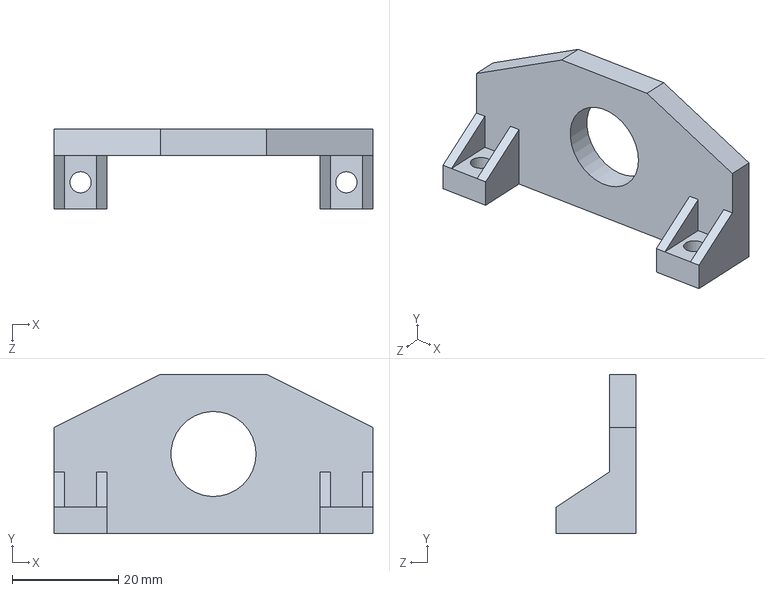
[picture p48: CAD file, 2018-09-26]
CAO/Base Roulante/SW_BR_1.0/support roues vé.SLDPRT
60.0 x 30.0 x 15.0 mm
