bubbulle/CDR_ATOM_FACTORY_2019/CAO/Base Roulante/SW_BR_2.0/support encodeurs.SLDPRT

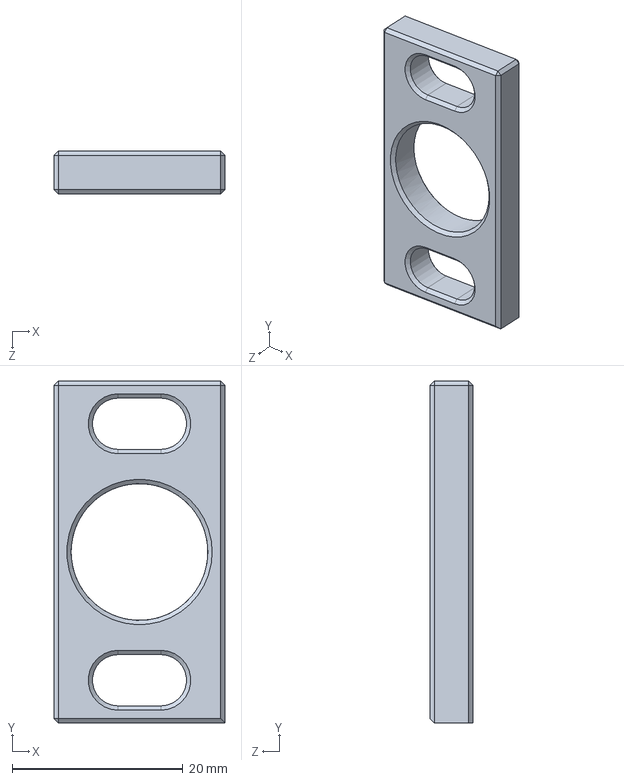
[picture p49: CAD file, 2018-09-26]
CAO/Base Roulante/SW_BR_2.0/support encodeurs.SLDPRT
20.0 x 40.0 x 5.00 mm
