bubbulle/CDR_ATOM_FACTORY_2019/CAO/Base Roulante/SW_BR_3.0/3.0/ecrou M6.SLDPRT

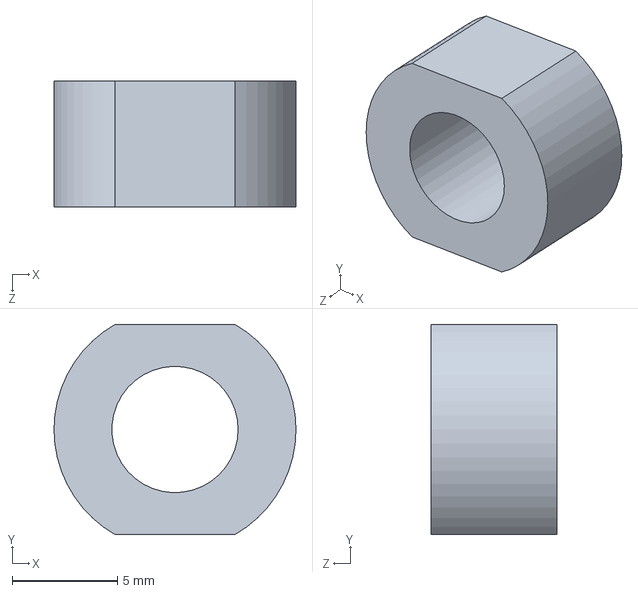
[picture p50: CAD file, 2018-09-26]
CAO/Base Roulante/SW_BR_3.0/3.0/ecrou M6.SLDPRT
11.5 x 10.0 x 6.00 mm
