bubbulle/CDR_ATOM_FACTORY_2019/CAO/Base Roulante/SW_BR_1.0/axe.SLDPRT

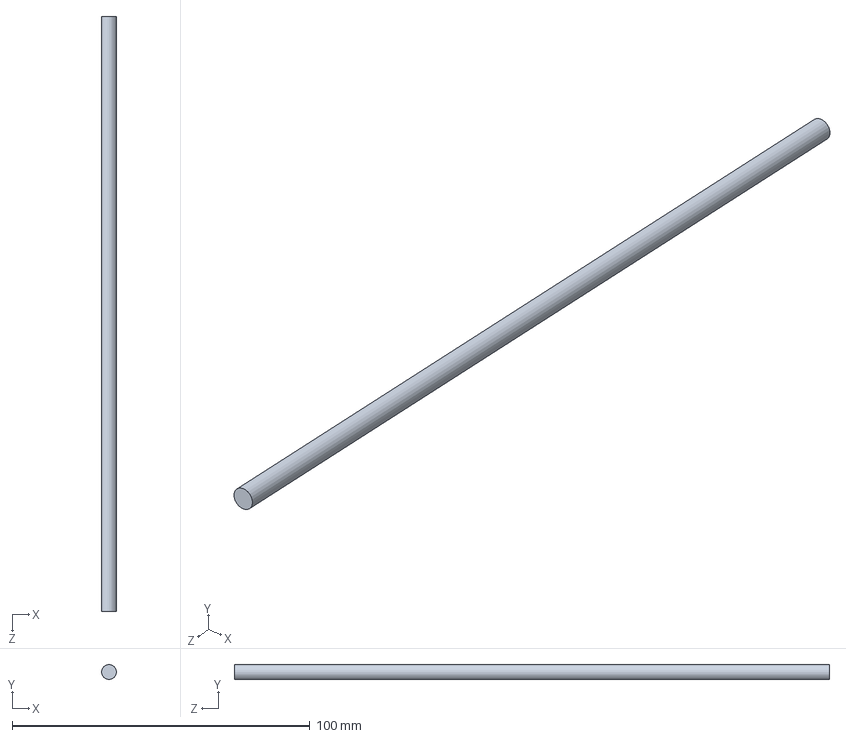
[picture p51: CAD file, 2018-09-26]
CAO/Base Roulante/SW_BR_1.0/axe.SLDPRT
5.00 x 5.00 x 200.0 mm
