bubbulle/CDR_ATOM_FACTORY_2019/CAO/Base Roulante/SW_BR_2.0/Pièce1.SLDPRT

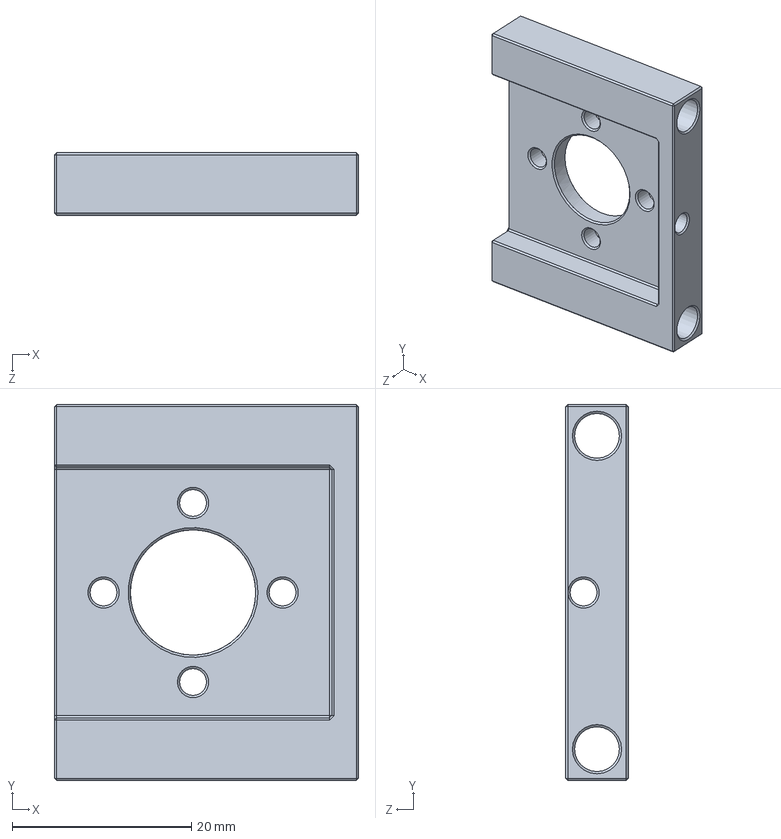
[picture p52: CAD file, 2018-09-26]
CAO/Base Roulante/SW_BR_2.0/Pièce1.SLDPRT
34.0 x 42.0 x 7.00 mm
