bubbulle/CDR_ATOM_FACTORY_2019/CAO/Base Roulante/SW_BR_3.0/3.0/Support fixe V3.SLDPRT

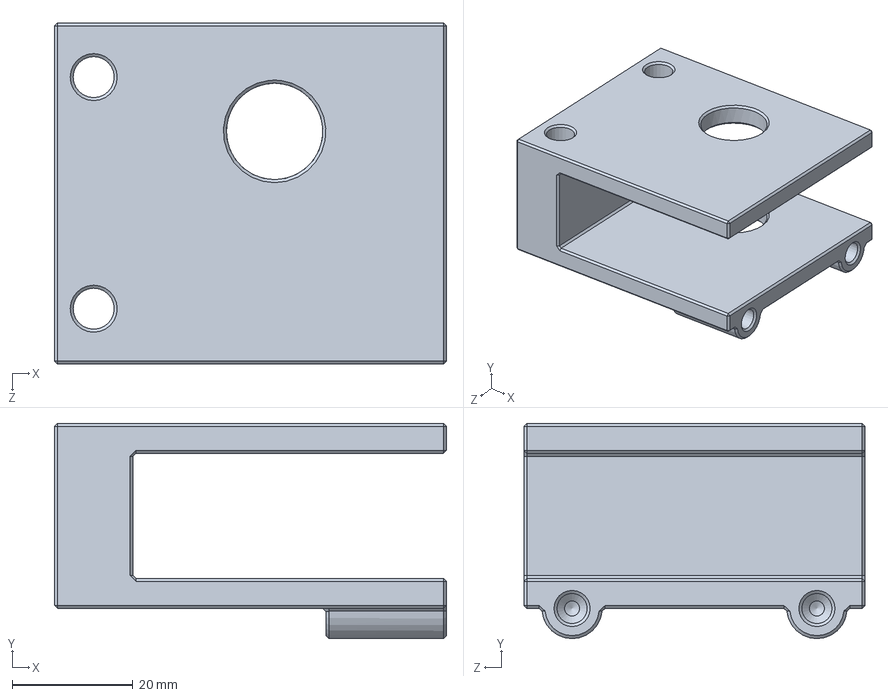
[picture p53: CAD file, 2018-09-26]
CAO/Base Roulante/SW_BR_3.0/3.0/Support fixe V3.SLDPRT
65.0 x 35.7 x 56.6 mm
