bubbulle/CDR_ATOM_FACTORY_2019/CAO/Base Roulante/SW_BR_1.0/goupille.SLDPRT

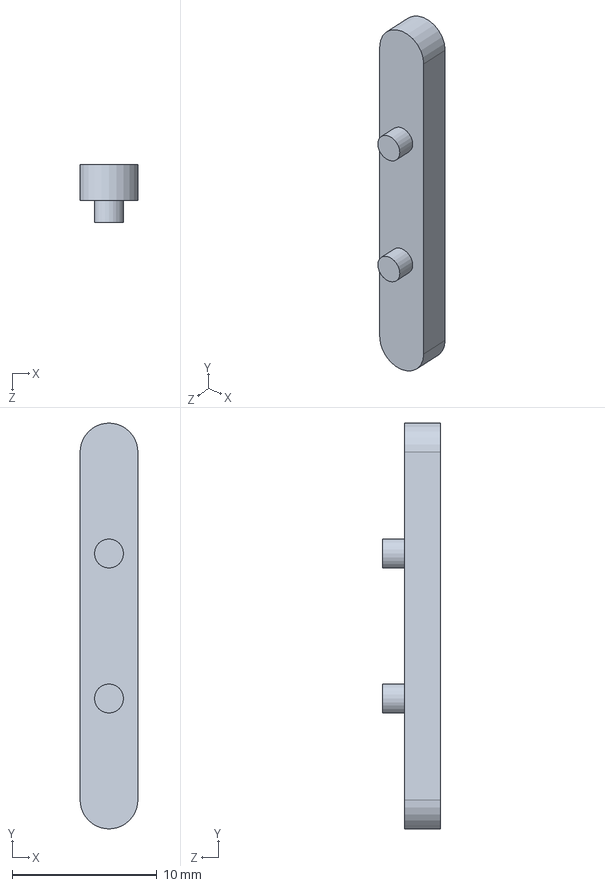
[picture p54: CAD file, 2018-09-26]
CAO/Base Roulante/SW_BR_1.0/goupille.SLDPRT
4.00 x 28.0 x 4.00 mm
