bubbulle/CDR_ATOM_FACTORY_2019/CAO/Base Roulante/SW_BR_2.0/codeurs.SLDPRT

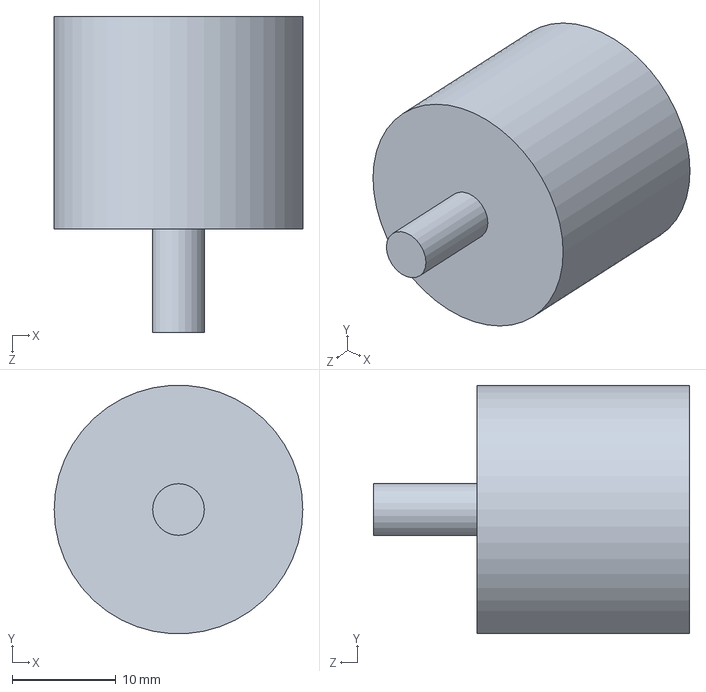
[picture p55: CAD file, 2018-09-26]
CAO/Base Roulante/SW_BR_2.0/codeurs.SLDPRT
24.0 x 23.9 x 30.5 mm
