bubbulle/CDR_ATOM_FACTORY_2019/CAO/Base Roulante/SW_BR_1.0/poulie.SLDPRT

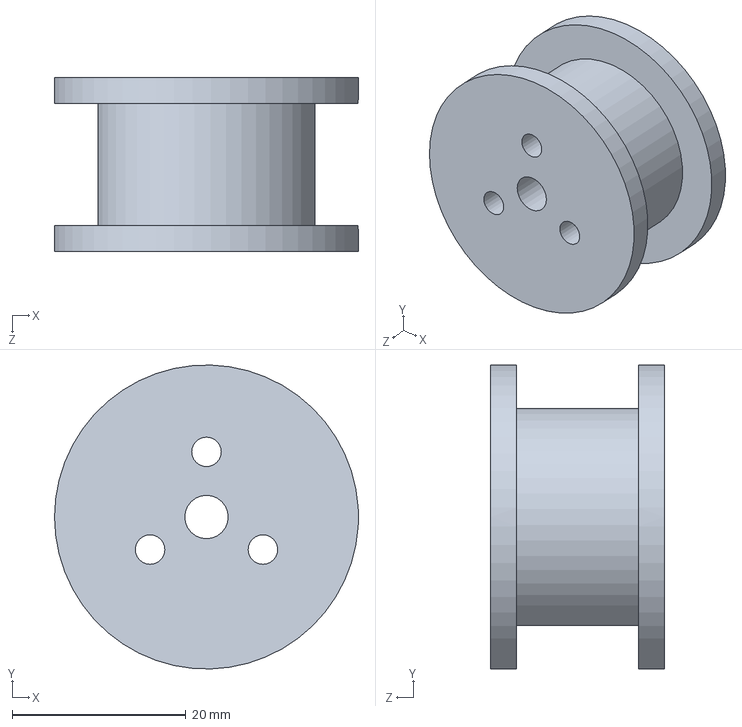
[picture p57: CAD file, 2018-09-26]
CAO/Base Roulante/SW_BR_1.0/poulie.SLDPRT
35.0 x 35.0 x 20.0 mm
