bubbulle/CDR_ATOM_FACTORY_2019/CAO/Base Roulante/SW_BR_2.0/tige.SLDPRT

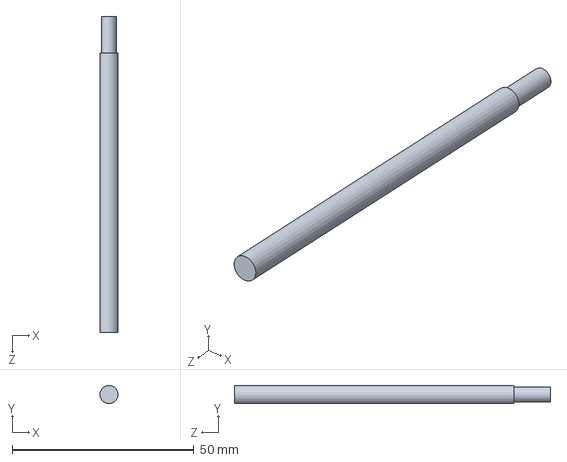
[picture p58: CAD file, 2018-09-26]
CAO/Base Roulante/SW_BR_2.0/tige.SLDPRT
5.00 x 5.00 x 87.0 mm
