bubbulle/CDR_ATOM_FACTORY_2019/CAO/Base Roulante/SW_BR_3.0/3.0/roues.SLDPRT

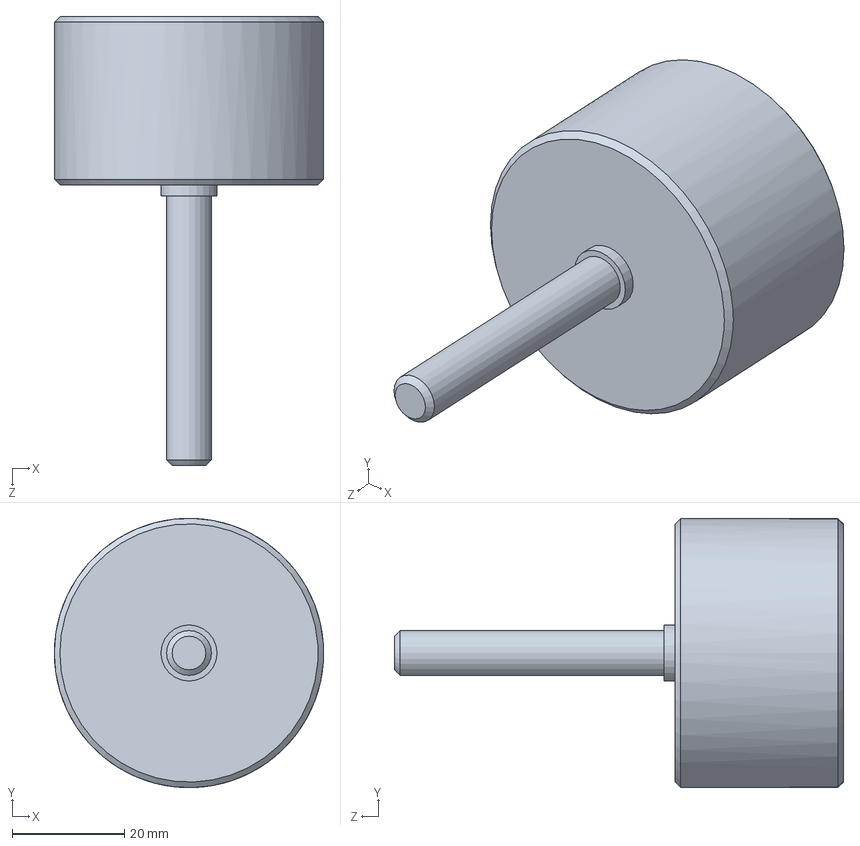
[picture p59: CAD file, 2018-09-26]
CAO/Base Roulante/SW_BR_3.0/3.0/roues.SLDPRT
48.0 x 48.0 x 80.0 mm
