bubbulle/CDR_ATOM_FACTORY_2019/CAO/Base Roulante/SW_BR_1.0/encodeur.SLDPRT

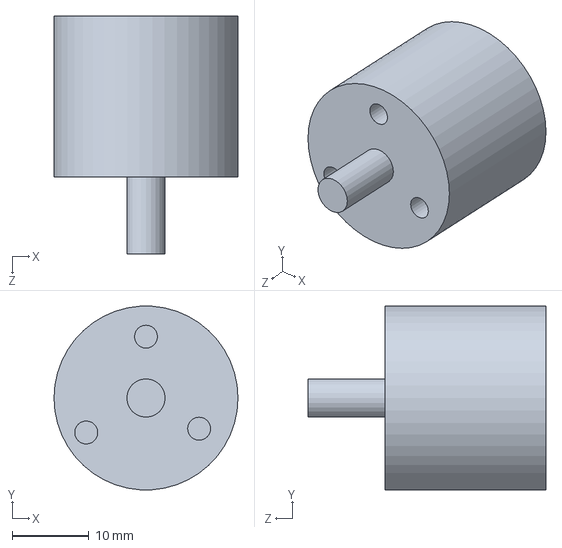
[picture p60: CAD file, 2018-09-26]
CAO/Base Roulante/SW_BR_1.0/encodeur.SLDPRT
24.0 x 23.9 x 31.0 mm
