bubbulle/CDR_ATOM_FACTORY_2019/CAO/Base Roulante/SW_BR_3.0/3.0/tige filté M7.SLDPRT

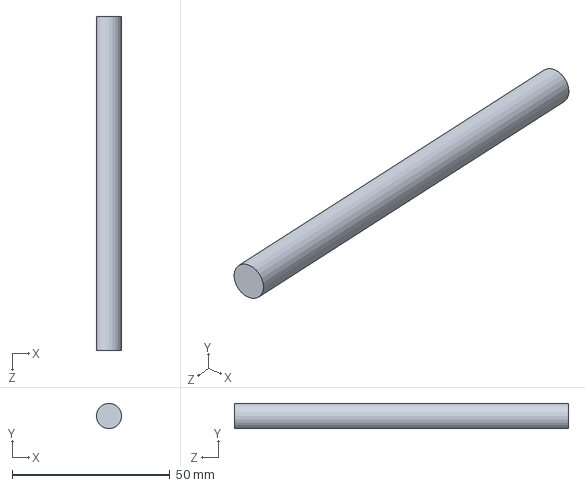
[picture p61: CAD file, 2018-09-26]
CAO/Base Roulante/SW_BR_3.0/3.0/tige filté M7.SLDPRT
8.00 x 8.00 x 106.0 mm
