bubbulle/CDR_ATOM_FACTORY_2019/CAO/Base Roulante/SW_BR_2.0/support moteur.SLDPRT

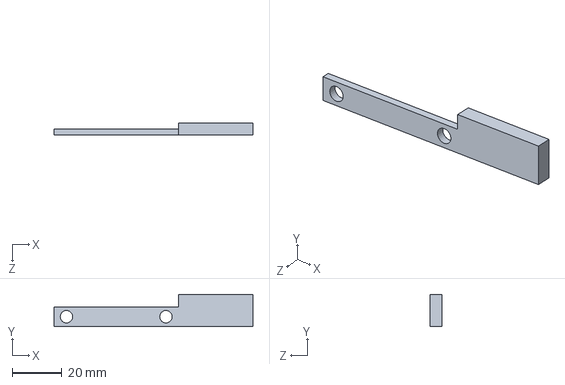
[picture p62: CAD file, 2018-09-26]
CAO/Base Roulante/SW_BR_2.0/support moteur.SLDPRT
80.0 x 13.0 x 5.00 mm
