bubbulle/CDR_ATOM_FACTORY_2019/CAO/Base Roulante/SW_BR_2.0/support roues.SLDPRT

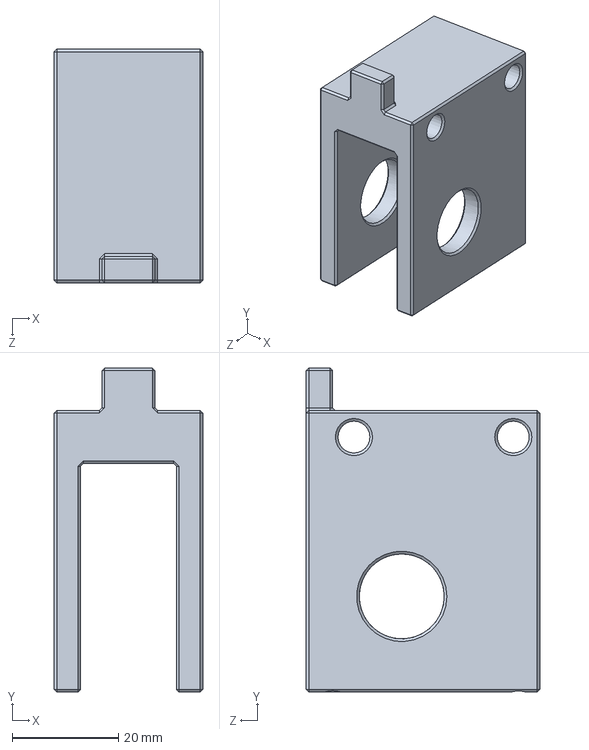
[picture p63: CAD file, 2018-09-26]
CAO/Base Roulante/SW_BR_2.0/support roues.SLDPRT
28.0 x 61.0 x 44.0 mm
