bubbulle/CDR_ATOM_FACTORY_2019/CAO/Base Roulante/SW_BR_3.0/3.0/o ring 41int 49ext 4 epaisseur.SLDPRT

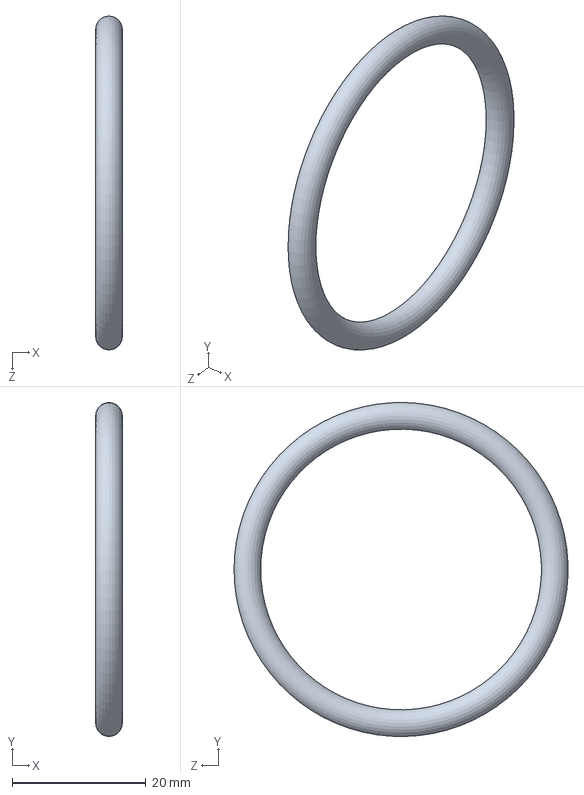
[picture p64: CAD file, 2018-09-26]
CAO/Base Roulante/SW_BR_3.0/3.0/o ring 41int 49ext 4 epaisseur.SLDPRT
4.00 x 50.0 x 50.0 mm
