bubbulle/CDR_ATOM_FACTORY_2019/CAO/Base Roulante/SW_BR_3.0/3.0/ecrou m7.SLDPRT

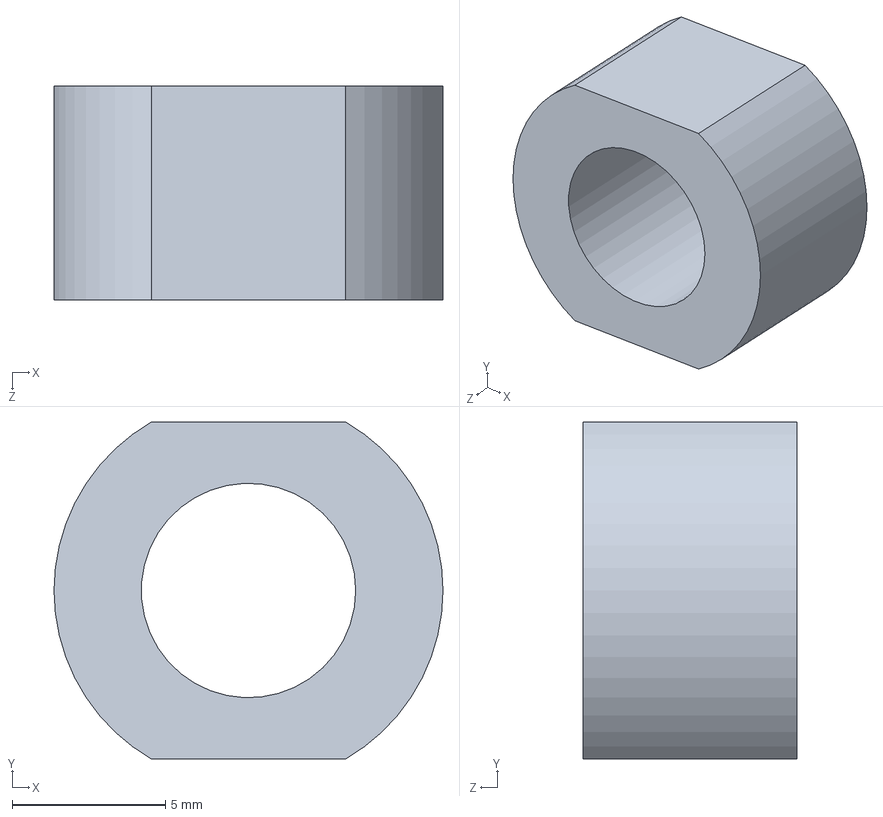
[picture p65: CAD file, 2018-09-26]
CAO/Base Roulante/SW_BR_3.0/3.0/ecrou m7.SLDPRT
12.7 x 11.0 x 7.00 mm
