bubbulle/CDR_ATOM_FACTORY_2019/CAO/Base Roulante/SW_BR_3.0/3.0/fixation encodeur V3.SLDPRT

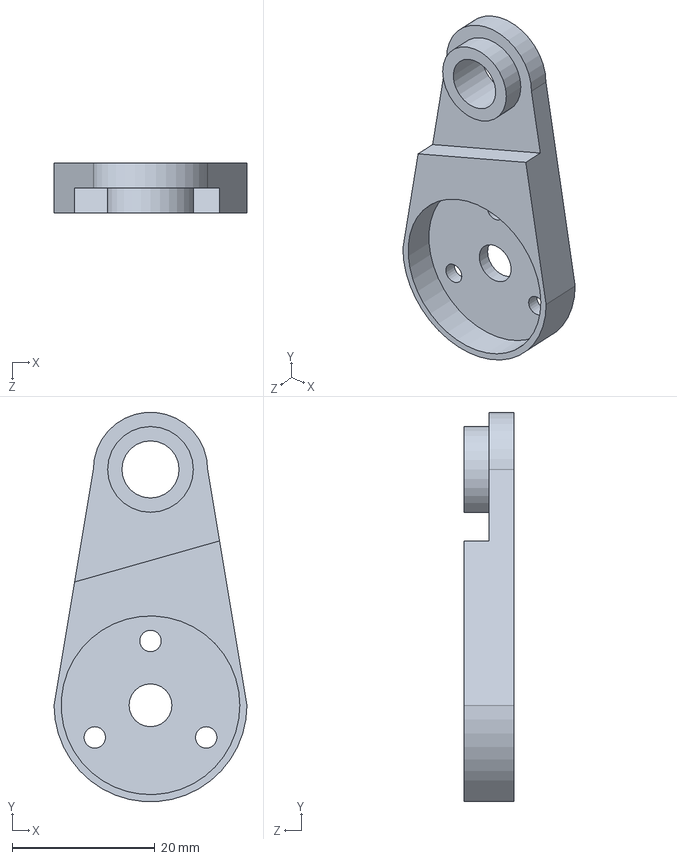
[picture p67: CAD file, 2018-09-26]
CAO/Base Roulante/SW_BR_3.0/3.0/fixation encodeur V3.SLDPRT
27.0 x 54.4 x 7.00 mm
