bubbulle/CDR_ATOM_FACTORY_2019/(list of files, cad)

Other CAD files:
CAO/Base Roulante/SW_BR_2.0/poulie 20 dents.SLDPRT
CAO/Base Roulante/SW_BR_3.0/3.0/poulie.SLDPRT
CAO/Base Roulante/SW_BR_1.0/Assemblage1.SLDDRW
CAO/Base Roulante/SW_BR_3.0/3.0/support encodeurs.STL
CAO/Base Roulante/SW_BR_3.0/3.0/support moteur V3.STL
